Morante-robotics/spider-bot-replica/cad/chassis/design-review.md

# <Design> · design review

Each answer with the number or the picture that shows it, not «yes».

| Question | Answer and evidence |
|---|---|
| Fits: every face pair against `fits.py`, at the worst position | |
| Strength: smallest section of every feature that takes force | |
| Held: what stops each part in each direction (`RETAIN`) | |
| Assembly: the steps as Morante's hands do them; how it comes apart | |
| Seats: every part fully home (section at full depth) | |
| Print: orientation, overhang, where support goes, can pliers reach it, why each cavity exists | |
| Marks: which, where, visible in which step | |
| Carry-over: what earlier versions had and whether it is still here | |

## As a stranger would see it
Five things that could still be wrong or awkward, and what was done about each.

## Pre-mortem
The three most likely ways it fails when printed, cleaned and assembled, and what prevents each.
