Morante-robotics/spider-bot-replica/ai-log.md

# Spider-Bot · AI log

Where AI (Claude) helped with the build, what it was asked, and what was checked by hand. Rules: every AI suggestion
needs a measurable test; mechanism parts are modelled by AI in code (build123d) and assembled and animated by me in Onshape before printing; soldering, batteries and
assembly are done by me.

| Date | Phase | Task | AI did | Checked by |
|---|---|---|---|---|
| 2026-11-08 | 2 · CAD | Carcass base model | Searched for faithful models and compared licenses; measured the 9 STLs and checked them for mesh errors; wrote [`tools/stl_preview.py`](tools/stl_preview.py) and [`tools/stl_turntable.py`](tools/stl_turntable.py) for the previews; [`tools/assemble_jenscolt.py`](tools/assemble_jenscolt.py) to assemble the full robot (eye sockets measured from the mesh, leg layout approximate) | Opened in Bambu Studio: imports, same mesh errors reported. Leg count (8) from the author's photos; exact leg layout not checked |
| 2026-11-09 | 2 · CAD | Motor, battery holder and print scale | Collected motor and holder sizes from shop listings; worked out voltage for 2×AA / 4×AAA against the N20 and the LEDs; wrote [`tools/fit_check.py`](tools/fit_check.py) to find the free space in the body and the smallest scale for each part | Pending: holder drawing checked when bought; fit checked again in Onshape with the mechanism |
| 2026-11-09 | 2 · CAD | Mesh repair | Diagnosed the mesh errors; wrote [`tools/repair_stl.py`](tools/repair_stl.py); rejected MeshFix after measuring it removed a 1.5 mm relief | Bambu Studio `--info`: `manifold = yes` for the 5 repaired parts; max deviation from the original 0.01 mm |
| 2026-11-09 | 3 · Mechanisms | Leg simulator and comparison | Found Klann's patent bar lengths and Jansen's numbers; wrote [`sim/legs.py`](sim/legs.py) (circle-intersection solver, Grashof check, gait metrics); random search for the toy leg; caught and fixed two errors of its own (Jansen triangle sides swapped; toy stance measured off the ground). Mistake: ruled out the toy leg on a 2D model that cannot represent it and did not offer it as an option; Morante noticed and chose it | Klann and Jansen foot paths match the published shapes (DIY Walkers). Toy leg: pending a 3D model |
| 2026-11-09 | 3 · Mechanisms | Toy leg in 3D | Measured the 8 leg notches in the base mesh; wrote [`sim/toy_leg_3d.py`](sim/toy_leg_3d.py) (8 legs, two gait groups, quasi-static walk, stability, gaps, slip) and searched the geometry for 3 crank axle directions × 2 joint types, each at its best; added a «feet outside the body» check after the first run folded legs under the carcass | Pending: notch swing and fit with holder and motor checked in Onshape; foot path checked on a printed leg |
| 2026-11-09 | 3 · Mechanisms | Toy leg on one crankshaft | Added a shared-crankshaft mode and stricter clearance checks (all leg pairs, inner arms, crank discs inside the base and below the battery holder) to [`sim/toy_leg_3d.py`](sim/toy_leg_3d.py); found that the inner arms colliding, not the shaft, halve the stride. Mistake: the footprint minimum it chose twisted the legs | Pending: the same checks in CAD (step 3) and on a printed leg |
| 2026-11-09 | 3 · Mechanisms | Crankshaft against real parts, two side crankshafts, four lateral crankshafts | Added an arm-to-crankshaft clearance rule and the `sides` and `rows` modes to [`sim/toy_leg_3d.py`](sim/toy_leg_3d.py); found that one crankshaft cannot fit, that side shafts move the feet sideways, and that bob limits the four-shaft stride. Mistake: the one-crankshaft geometry chosen the day before had never been checked against solid cranks | Searches re-run with 3–5 seeds each; the four-shaft geometry checked again in CAD |
| 2026-11-10 | 3 · Mechanisms | Legs and drive in CAD | Added buildable limits to the search; wrote `cad/drive/build.py` (since split into [`cad/legs/`](cad/legs/), [`cad/crankshafts/`](cad/crankshafts/), [`cad/gear-train-test/`](cad/gear-train-test/) and [`cad/test-frame/`](cad/test-frame/)) (legs, forks, crankshafts with involute gears, idlers, spine, test frame) and [`cad/legs/check.py`](cad/legs/check.py) (overlap and gap of every pair over a full turn); fixed the six problems it found, one of them its own placement bug | `check.py`: no overlaps every 30°; Bambu Studio `--info`: `manifold = yes` for all STLs. Pending: Onshape assembly by Morante, a printed leg turned by hand |
| 2026-11-10 | 2 · CAD | Onshape assembly | Wrote the step-by-step tutorial [`cad/test-frame/onshape.md`](cad/test-frame/onshape.md) (first in Spanish, then in English), with the offsets worked out from the CAD parameters and the simulator's foot positions; wrote [`cad/test-frame/onshape_figures.py`](cad/test-frame/onshape_figures.py) for a picture of every mate. Mistake: did not say that the offset sign depends on the connector's axis | Morante assembled and animated it in Onshape; Claude checked the mates in the shared document. Foot positions not measured |
| 2026-11-10 | 2 · CAD | Clearance test and test leg print plate | Wrote [`cad/clearance-test/build.py`](cad/clearance-test/build.py) and [`tools/bambu_plate.py`](tools/bambu_plate.py) (orient, arrange and slice with Bambu Studio's CLI); found that the leg would not lie flat and fixed it; located the overhangs Bambu Studio cannot support. Mistake: the first fix (a wider leg) took away the clearance between the middle legs, caught by `check.py` | `check.py` over a full turn; Bambu Studio slice and preview. Pending: the printed parts and the clearance result |
| 2026-11-11 | 3 · Mechanisms | Test leg: first assembly and clearance result | Drew the screw diagram ([`cad/test-frame/screws_figure.py`](cad/test-frame/screws_figure.py)); found its own design faults from Morante's photos (frame arms ending at the centre of their holes; self-tapping holes M3 would not enter) and redesigned the fork's pivot; split the clearance in two from the block's result. Mistakes: the half-open arm holes and the 0.2 mm clearance guess | Morante's assembly and clearance block; `check.py` over a full turn. Reprint ([Test leg v2](build-log/3-legs-and-drive.md#test-leg-v2-turning-by-hand)): the frame holds and the leg turns with 0.5 mm; one fork came out too tight for the leg (0.2 mm a side in the window) |
| 2026-11-11 | 3 · Mechanisms | Base v1 in CAD | Widened the fork's window and thinned crankshaft 4's crank arms; checked the drive against the carcass body and found the forks and rear legs inside it; drew three ways out; wrote [`cad/base/build.py`](cad/base/build.py) (mesh booleans: band, hollow bowl, built-in spine with keel, fork pockets and screws, cap), [`cad/base/check.py`](cad/base/check.py) and [`cad/base/figures.py`](cad/base/figures.py). Mistakes: the drive had been designed against the base alone, never against the body; the first window fix gave 0.25 mm a side instead of 0.5, caught before printing | `check.py` every 10°: no overlaps against base, cap, front block and lifted body; Bambu Studio sliced the plate. Pending: print and assemble |
| 2026-11-11 | 3 · Mechanisms | Gear train test | Diagnosed the jam from Morante's video; wrote the general check [`tools/cad_verify.py`](tools/cad_verify.py) (integrity, collisions with gears turning, backlash, what holds each part, assembly order, overhangs), its [spec for this test](cad/gear-train-test/verify.py) and [`cad/crankshafts/gear_phase_figure.py`](cad/crankshafts/gear_phase_figure.py); found that idlers 1 and 2 cannot mesh with both crankshafts at the designed crank angles. Mistakes: the earlier check skipped gear pairs and never turned the idlers; the test spine had open slots and no cap; zero backlash | The new check reproduces both faults seen in the video (crankshafts lifting, jamming); it passes a closed bore and fails an open slot in a self-test. Redesign: [Gear train v2 in CAD](build-log/3-legs-and-drive.md#gear-train-v2-in-cad), pending its print |
| 2026-11-11 | 3 · Mechanisms | Gear train v2 in CAD | As the cad-designer subagent: worked out a gear offset per crankshaft so every idler meshes with both neighbours at the gait angles, raised idlers 1 and 2 to 12 teeth, added backlash, a test cap and assembly dots; wrote [`cad/crankshafts/check_gear_train.py`](cad/crankshafts/check_gear_train.py) and the new [spec](cad/gear-train-test/verify.py); rebuilt base v1's keel | `cad_verify` PASS every 5°, 2D mesh check every 1°, base and drive checks with no overlaps. Printed ([Gear train test v2: the cap](build-log/3-legs-and-drive.md#gear-train-test-v2-the-cap)): the train turns without the cap; the test cap jammed it |
| 2026-11-12 | 3 · Mechanisms | Gear train test v2: the cap | Diagnosed the jam from Morante's videos and caliper measurements; as the cad-designer subagent, narrowed the cap's tongues, added skirts to centre it, gave [`tools/cad_verify.py`](tools/cad_verify.py) keep-out zones and posed the cap and shafts at their extremes; applied the same fix to base v1's cap; drew [`cad/gear-train-test/assembly_figure.py`](cad/gear-train-test/assembly_figure.py). Mistakes: first blamed the backlash; the verifier had placed loose parts only at nominal and counted the crankshafts as holding the cap | `cad_verify` PASS every 5°, worst gap to a gear face 0.90 mm; the first cap fails the new spec. Morante printed the new cap: the four shafts turn together |
| 2026-11-14 | 3 · Mechanisms | Whole robot first: motor sizing and chassis plan | As a subagent, wrote [`sim/motor_sizing.py`](sim/motor_sizing.py) (crank torque over a turn by virtual work on the 3D toy leg, worst weight split by linear programming, joint friction, Pololu N20 data scaled to the battery voltage) and chose the HP 380:1. As the cad-designer subagent, wrote the whole-robot plan [`cad/chassis/design-plan.md`](cad/chassis/design-plan.md) in four revisions, with [`plan_figure.py`](cad/chassis/plan_figure.py) and [`mass_estimate.py`](cad/chassis/mass_estimate.py); the design-reviewer subagent checked it twice and asked for changes each time (among them leg 3R passing the motor at deck level, and a contingency by source on the mass). As the documenter, drew [`sim/motor_sizing_figure.py`](sim/motor_sizing_figure.py) and wrote the entry | Pending: the mass and sizing rerun on the modelled parts; the break coupons K6a and K6b (stall rule); the motor's margin and the train's efficiency (T1) on v0 |
