Morante-robotics/spider-bot-replica/cad/chassis/images/plan-top.png

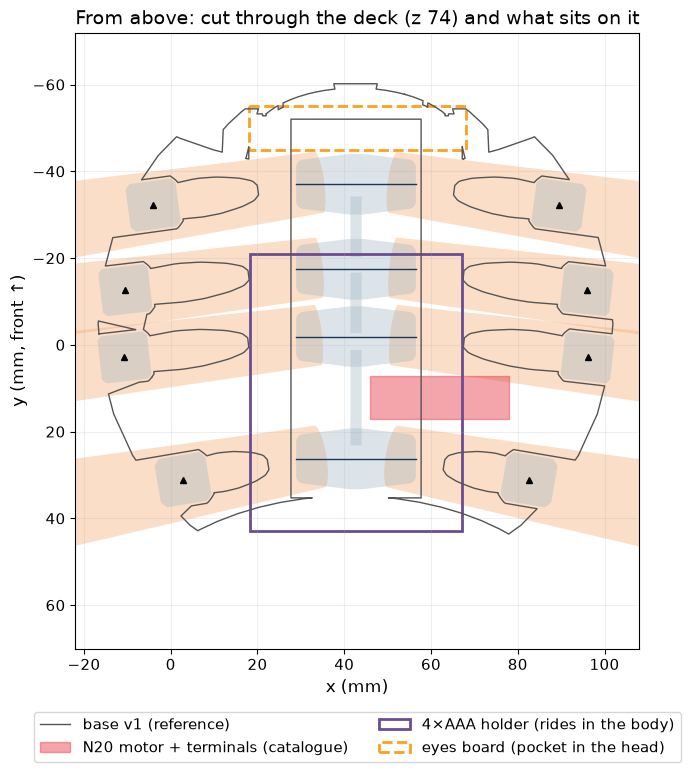
cad/chassis/images/plan-top.png
