Morante-robotics/spider-bot-replica/sim/images/drive-options.png

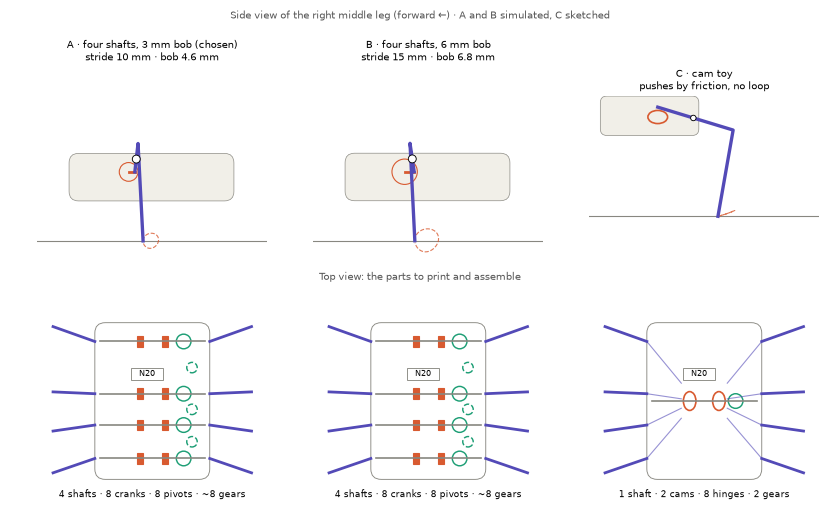
sim/images/drive-options.png
