Morante-robotics/spider-bot-replica/sim/images/toy-3d-rows-cad.gif

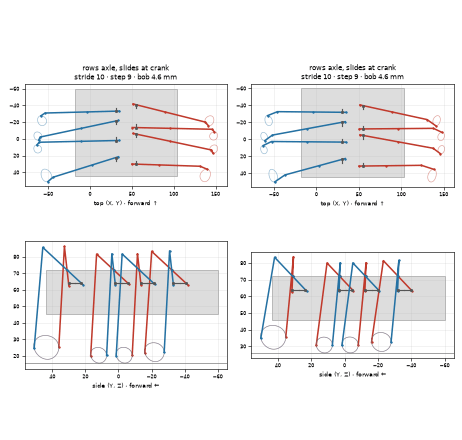
sim/images/toy-3d-rows-cad.gif
