Morante-robotics/spider-bot-replica/cad/legs/out/assembly-0.stl

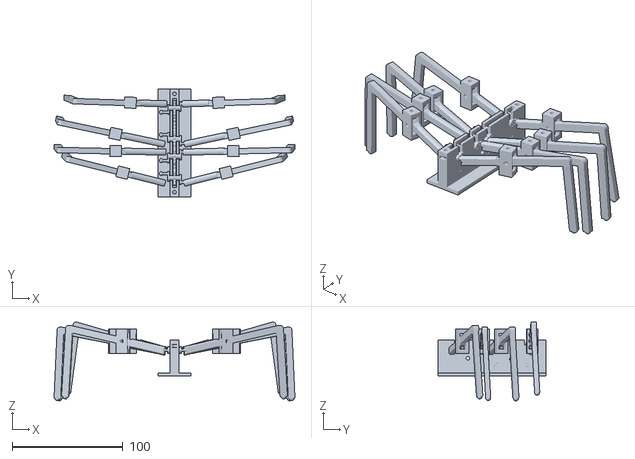
[picture p34: CAD file, 2026-11-11]
cad/legs/out/assembly-0.stl
218.0 x 97.3 x 71.3
