Morante-robotics/spider-bot-replica/cad/base/out/cap.stl

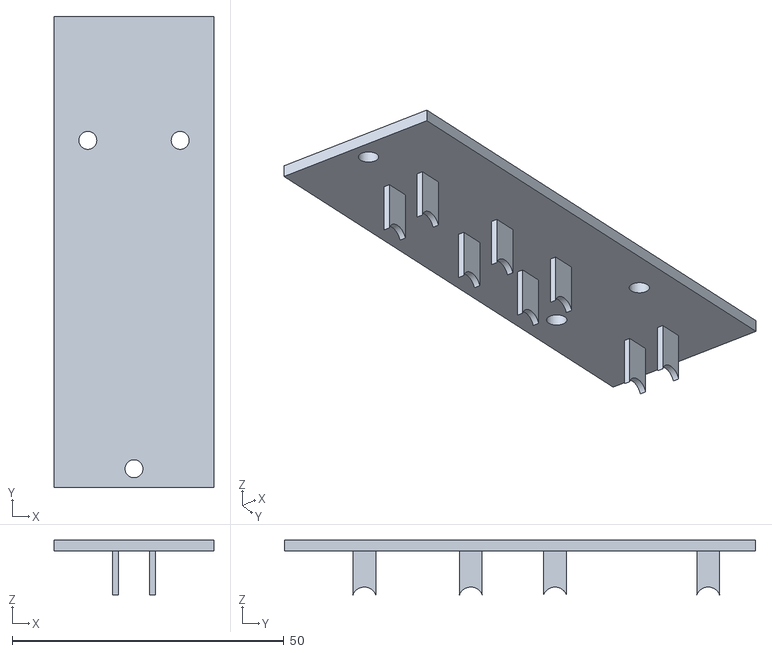
[picture p35: CAD file, 2026-11-12]
cad/base/out/cap.stl
29.4 x 86.7 x 10.1
