Morante-robotics/spider-bot-replica/cad/carcass-120/spideybot_eye.stl

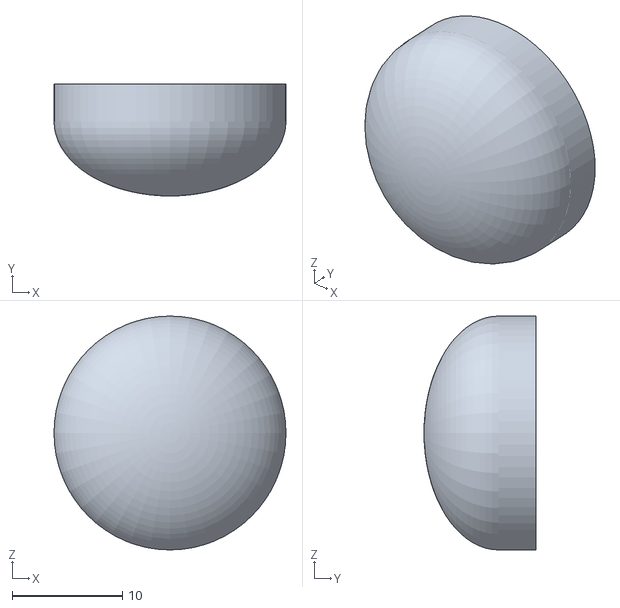
[picture p36: CAD file, 2026-11-09]
cad/carcass-120/spideybot_eye.stl
21.0 x 10.2 x 21.2
