Morante-robotics/spider-bot-replica/cad/carcass-jenscolt/spideybot_R_leg2.stl

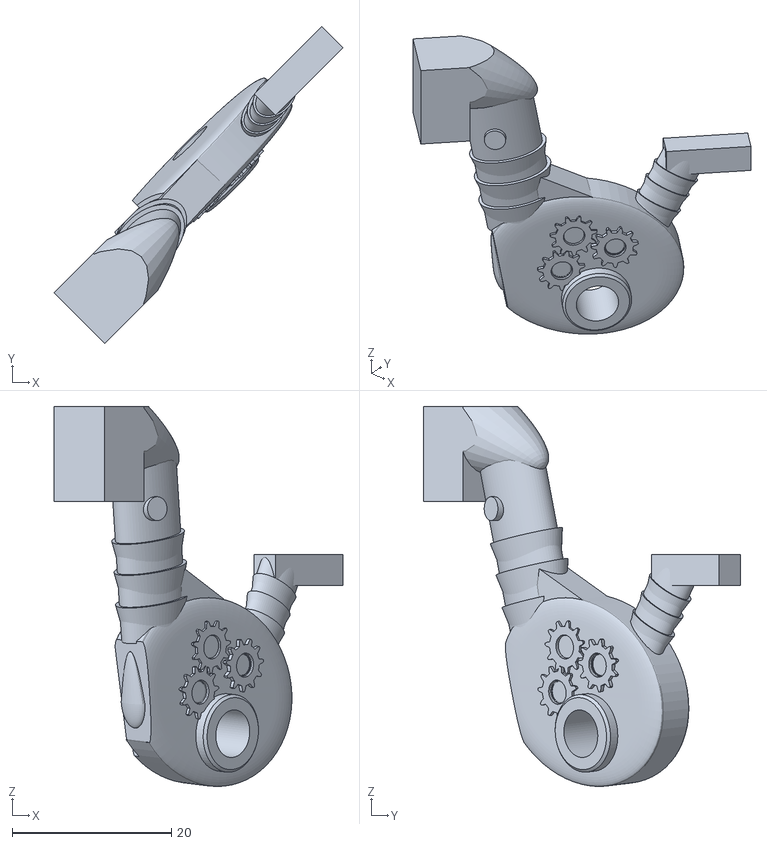
[picture p37: CAD file, 2026-11-07]
cad/carcass-jenscolt/spideybot_R_leg2.stl
36.3 x 39.9 x 47.8
