Morante-robotics/spider-bot-replica/cad/clearance-test/clearance-pin.step

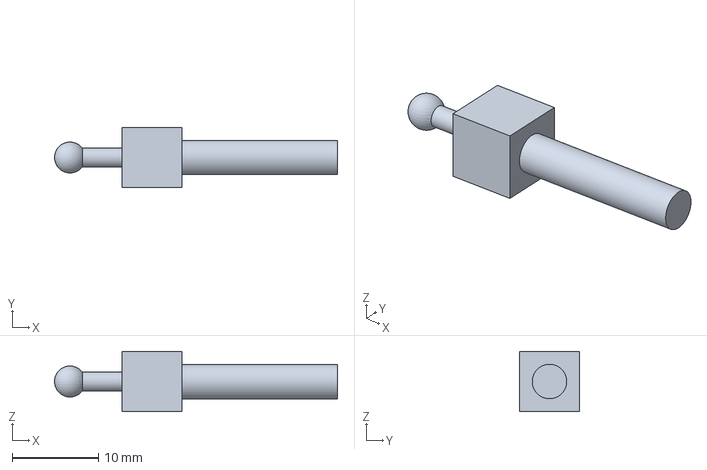
[picture p38: CAD file, 2026-11-10]
cad/clearance-test/clearance-pin.step
32.8 x 7.00 x 7.00 mm
