Morante-robotics/spider-bot-replica/cad/crankshafts/out/crankshaft-3.step

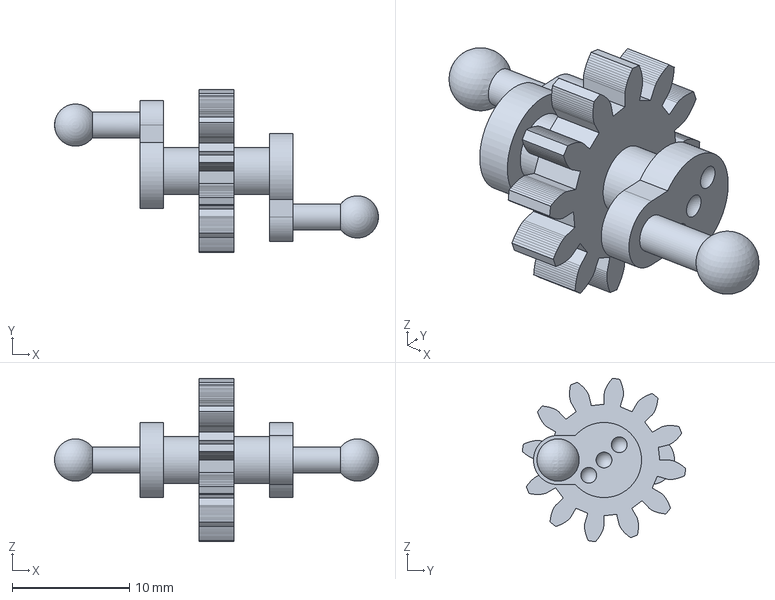
[picture p39: CAD file, 2026-11-11]
cad/crankshafts/out/crankshaft-3.step
27.6 x 13.9 x 13.9 mm
