Morante-robotics/spider-bot-replica/cad/gear-train-test/out/test-cap.step

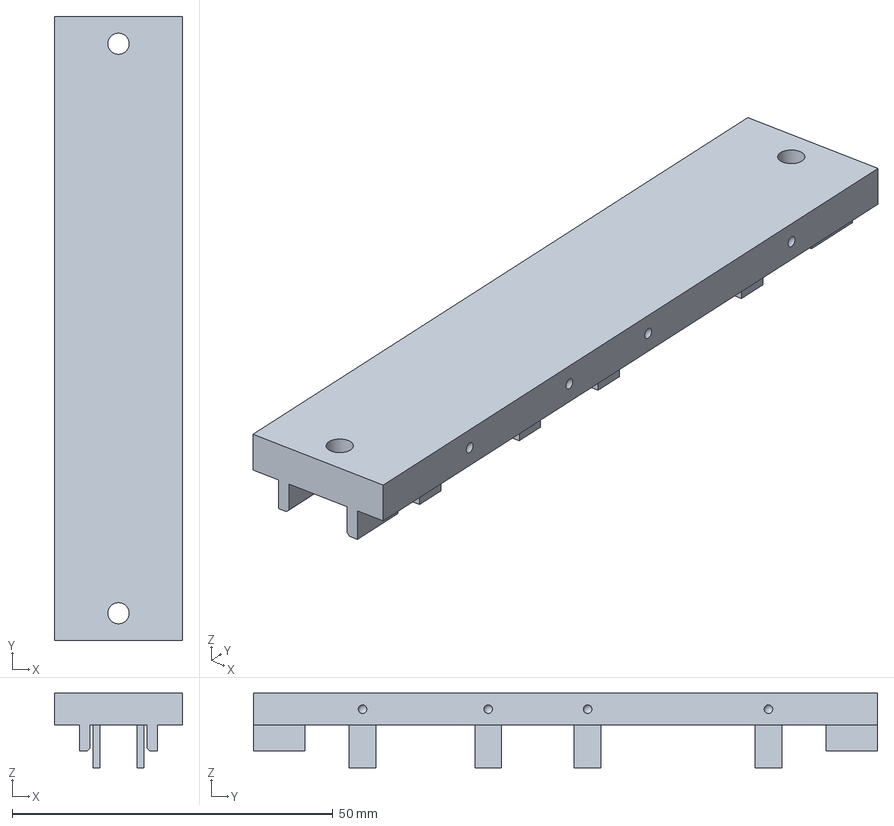
[picture p40: CAD file, 2026-11-12]
cad/gear-train-test/out/test-cap.step
20.0 x 97.3 x 11.6 mm
