Morante-robotics/spider-bot-replica/cad/test-frame/out/test-frame.step

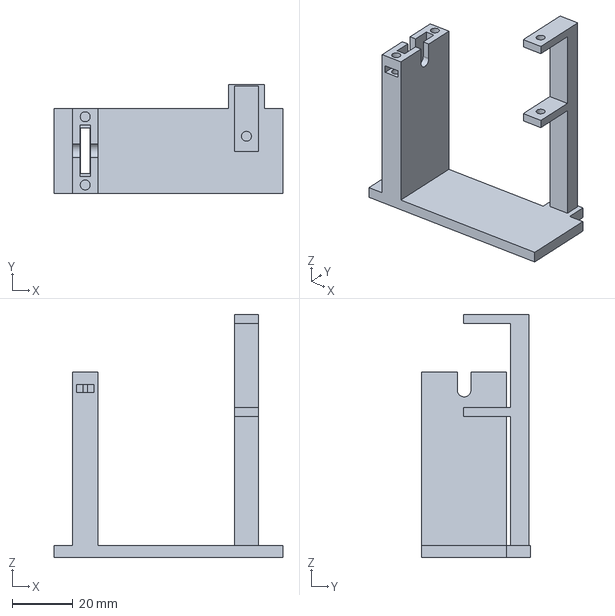
[picture p41: CAD file, 2026-11-11]
cad/test-frame/out/test-frame.step
75.4 x 35.8 x 80.1 mm
