Morante-robotics/spider-bot-replica/print/legs-forks-v1.3mf

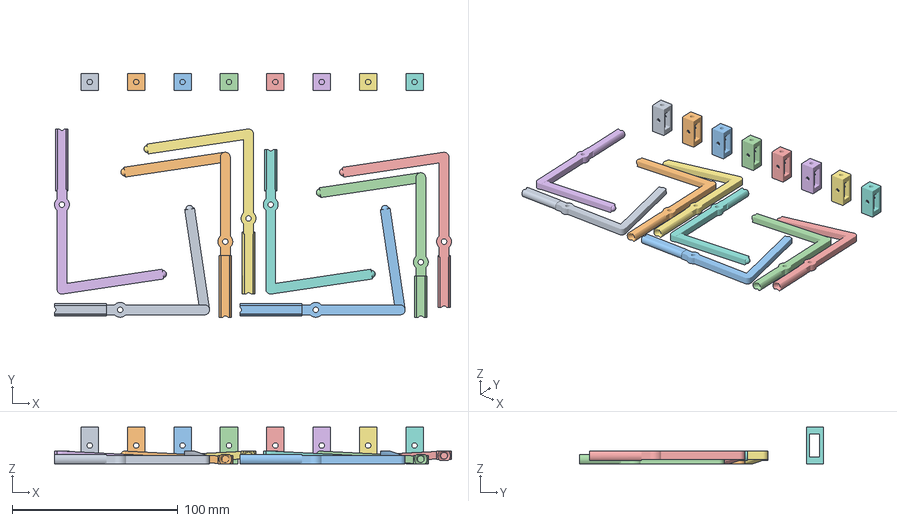
[picture p42: CAD file, 2026-11-12]
print/legs-forks-v1.3mf
239.6 x 147.0 x 22.0 mm
leg-front-right-0.stl
leg-middle-right-1.stl
leg-middle-right-2.stl
leg-rear-right-3.stl
leg-front-left-4.stl
leg-middle-left-5.stl
leg-middle-left-6.stl
leg-rear-left-7.stl
pivot-8.stl
pivot-9.stl
pivot-10.stl
pivot-11.stl
pivot-12.stl
pivot-13.stl
pivot-14.stl
pivot-15.stl
