Morante-robotics/spider-bot-replica/cad/base/out/base-v1.stl

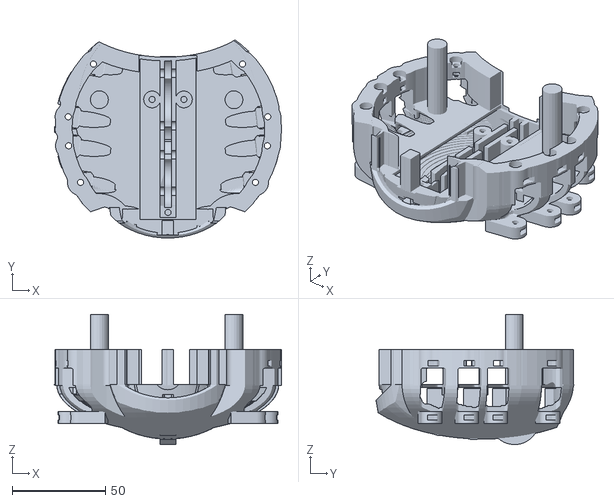
[picture p43: CAD file, 2026-11-11]
cad/base/out/base-v1.stl
121.4 x 106.0 x 69.6
