Morante-robotics/spider-bot-replica/cad/carcass-120/spideybot_sensor.stl

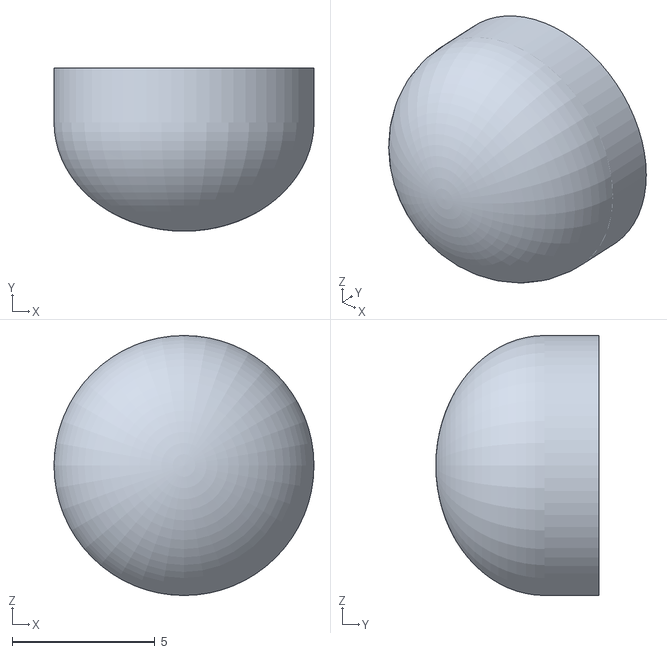
[picture p44: CAD file, 2026-11-09]
cad/carcass-120/spideybot_sensor.stl
9.12 x 5.73 x 9.12
