Morante-robotics/spider-bot-replica/cad/carcass-jenscolt/spideybot_small_eye.stl

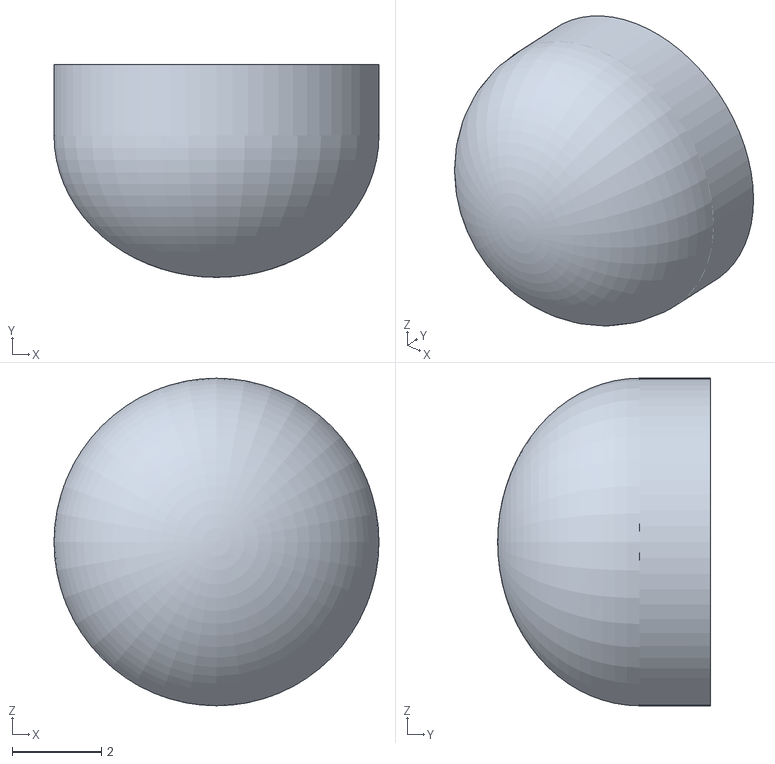
[picture p45: CAD file, 2026-11-07]
cad/carcass-jenscolt/spideybot_small_eye.stl
7.30 x 4.78 x 7.36
