Morante-robotics/spider-bot-replica/cad/clearance-test/clearance-block.step

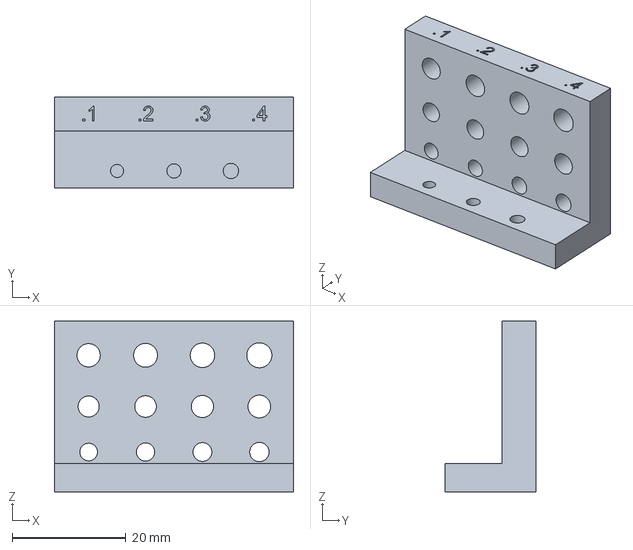
[picture p46: CAD file, 2026-11-10]
cad/clearance-test/clearance-block.step
42.0 x 16.0 x 30.0 mm
