Morante-robotics/spider-bot-replica/cad/gear-train-test/out/spine.step

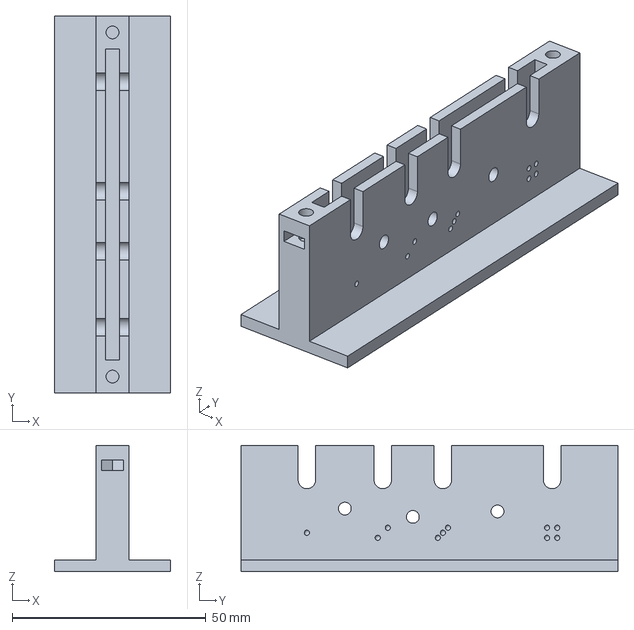
[picture p47: CAD file, 2026-11-11]
cad/gear-train-test/out/spine.step
30.0 x 97.3 x 32.5 mm
