Morante-robotics/spider-bot-replica/cad/legs/out/leg-front-right.step

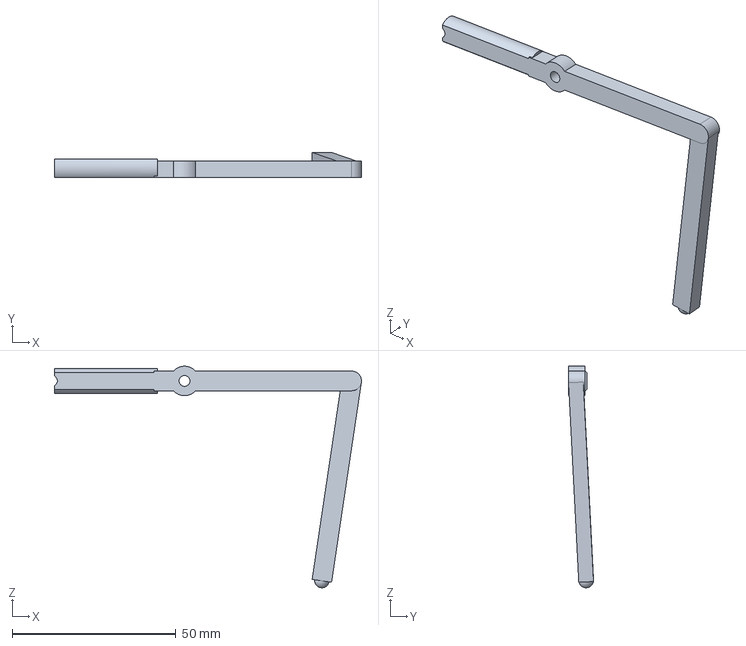
[picture p48: CAD file, 2026-11-11]
cad/legs/out/leg-front-right.step
93.6 x 7.62 x 67.6 mm
