Morante-robotics/spider-bot-replica/cad/test-frame/out/test-frame-keeper.step

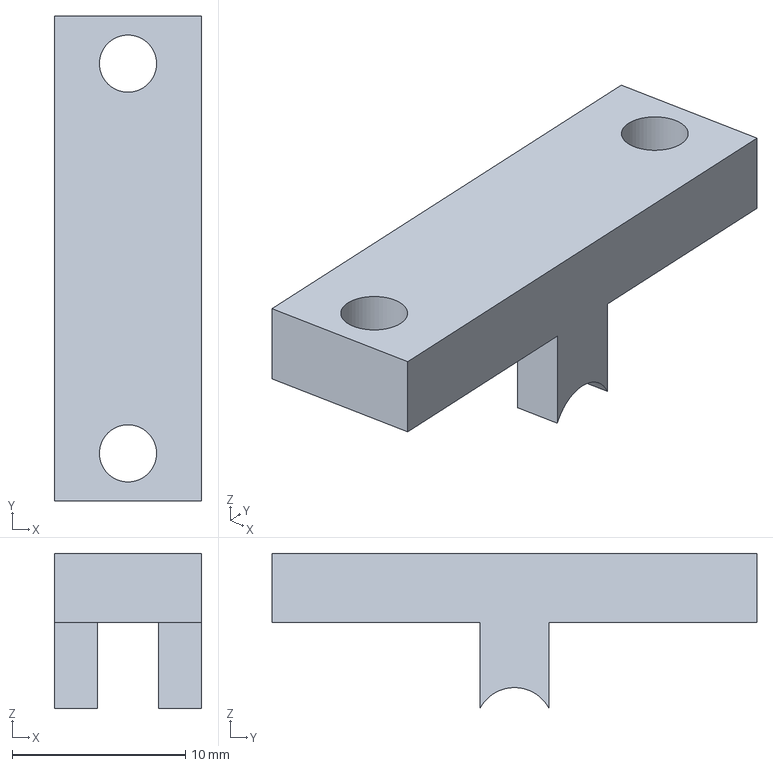
[picture p49: CAD file, 2026-11-11]
cad/test-frame/out/test-frame-keeper.step
8.50 x 28.0 x 8.97 mm
