Morante-robotics/spider-bot-replica/print/base-v1.3mf

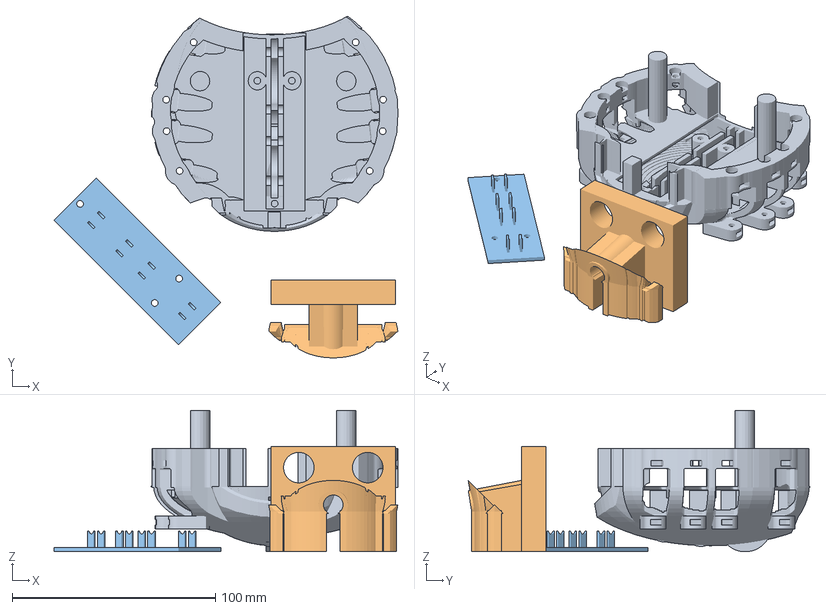
[picture p50: CAD file, 2026-11-12]
print/base-v1.3mf
169.3 x 168.2 x 69.6 mm
base-v1.stl
front-block.stl
cap.stl
