Morante-robotics/spider-bot-replica/cad/base/out/front-block.stl

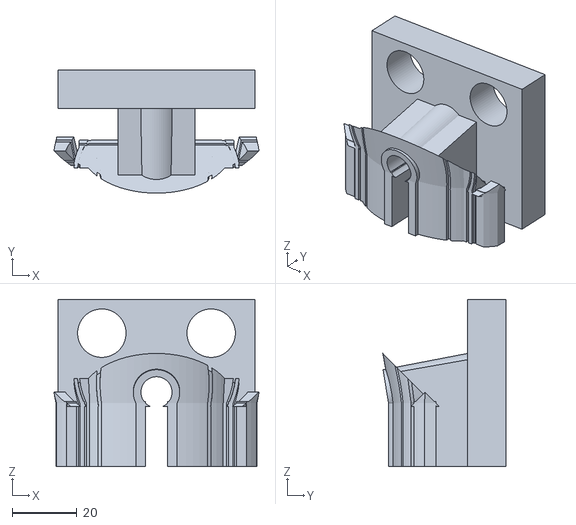
[picture p51: CAD file, 2026-11-11]
cad/base/out/front-block.stl
63.5 x 38.2 x 51.9
