Morante-robotics/spider-bot-replica/cad/carcass-120/spideybot_body.stl

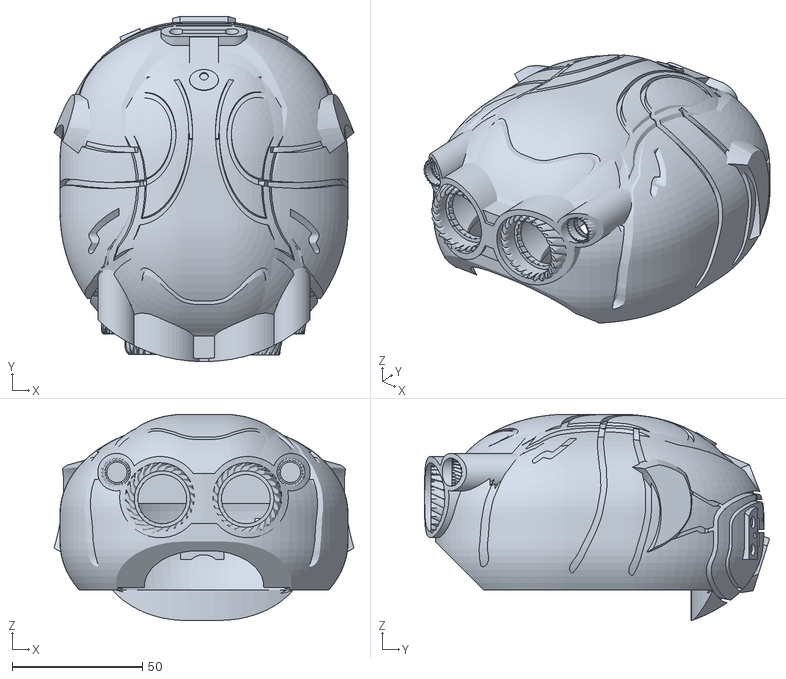
[picture p52: CAD file, 2026-11-09]
cad/carcass-120/spideybot_body.stl
115.2 x 132.6 x 79.2
