Morante-robotics/spider-bot-replica/cad/carcass-jenscolt/spideybot_L_leg1.stl

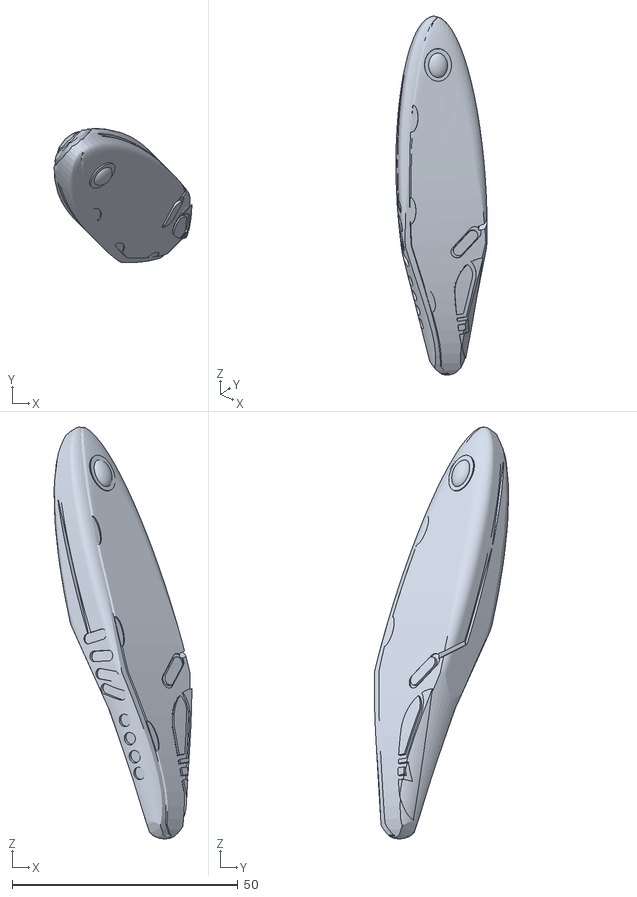
[picture p53: CAD file, 2026-11-07]
cad/carcass-jenscolt/spideybot_L_leg1.stl
30.5 x 29.7 x 91.3
