Morante-robotics/spider-bot-replica/cad/crankshafts/out/idler-2.step

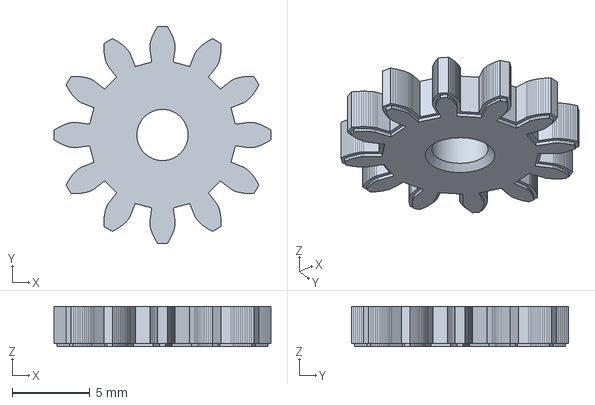
[picture p54: CAD file, 2026-11-11]
cad/crankshafts/out/idler-2.step
14.0 x 14.0 x 2.60 mm
