Morante-robotics/spider-bot-replica/cad/legs/out/leg-rear-left.step

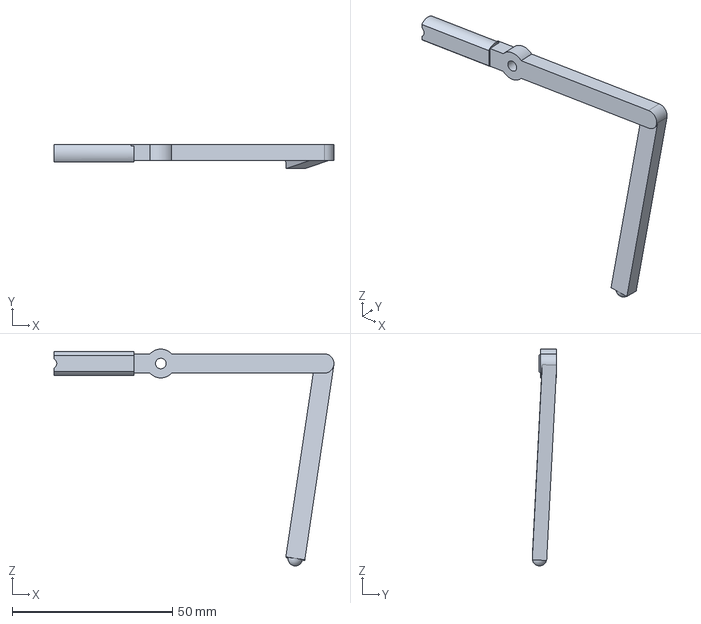
[picture p55: CAD file, 2026-11-11]
cad/legs/out/leg-rear-left.step
87.3 x 7.62 x 67.6 mm
