Morante-robotics/spider-bot-replica/cad/carcass-120/spideybot_base.stl

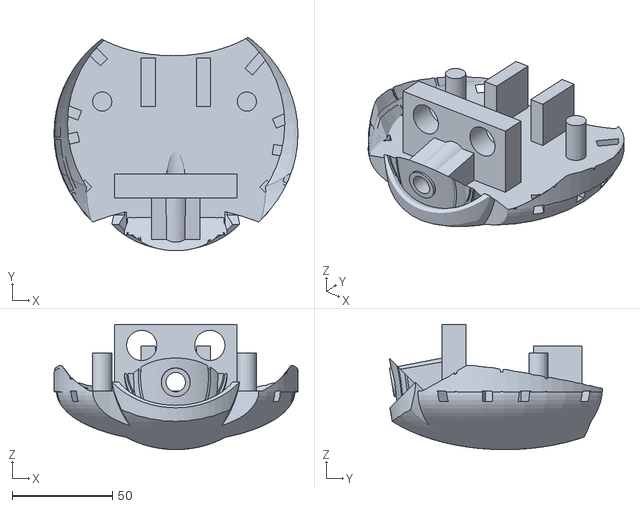
[picture p56: CAD file, 2026-11-09]
cad/carcass-120/spideybot_base.stl
121.4 x 106.2 x 62.4
