Morante-robotics/spider-bot-replica/cad/carcass-jenscolt/spideybot_eye.stl

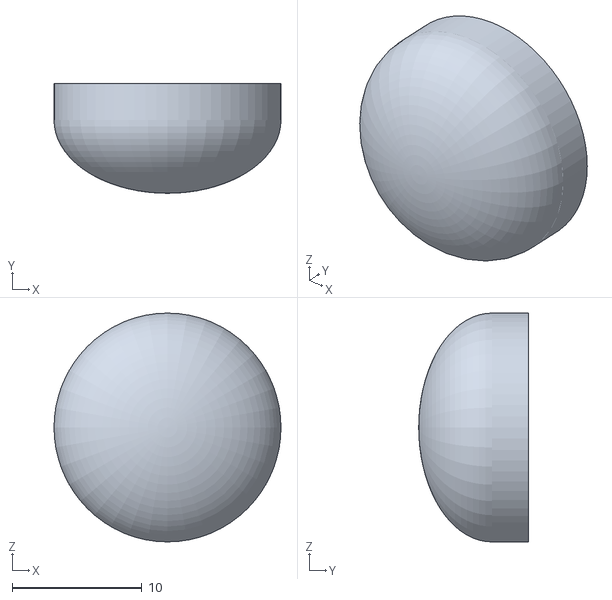
[picture p57: CAD file, 2026-11-07]
cad/carcass-jenscolt/spideybot_eye.stl
17.5 x 8.46 x 17.7
