Morante-robotics/spider-bot-replica/cad/crankshafts/out/crankshaft-4.step

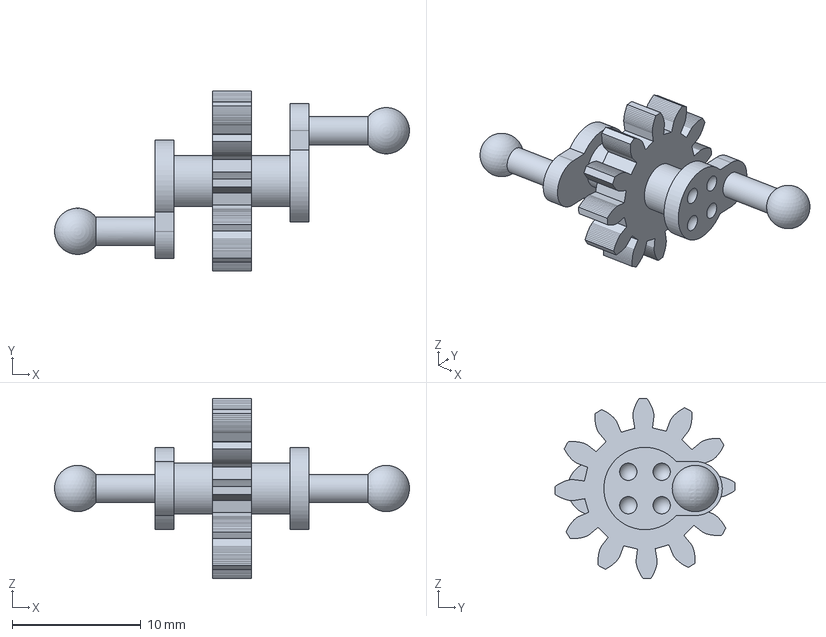
[picture p58: CAD file, 2026-11-11]
cad/crankshafts/out/crankshaft-4.step
27.6 x 14.0 x 14.0 mm
