Morante-robotics/spider-bot-replica/cad/legs/out/leg-middle-right.step

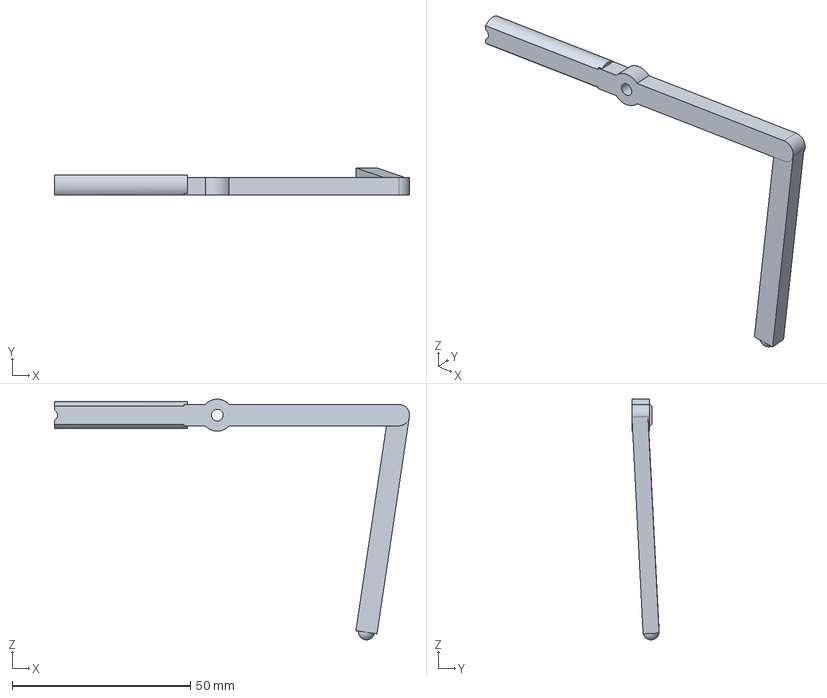
[picture p59: CAD file, 2026-11-11]
cad/legs/out/leg-middle-right.step
99.7 x 7.62 x 67.6 mm
