Morante-robotics/spider-bot-replica/print/gear-train-test-v2.3mf

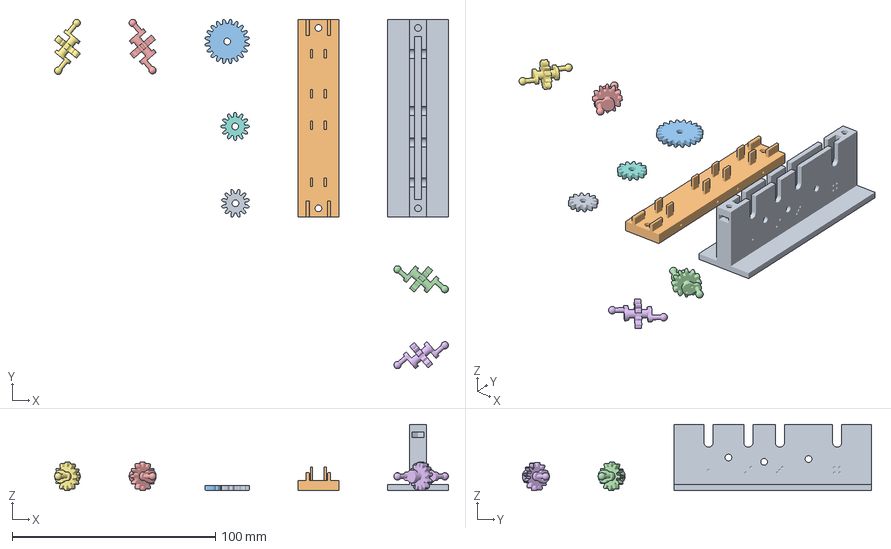
[picture p60: CAD file, 2026-11-12]
print/gear-train-test-v2.3mf
193.9 x 172.0 x 32.5 mm
spine.stl
test-cap.stl
idler-3.stl
crankshaft-2.stl
crankshaft-1.stl
crankshaft-3.stl
crankshaft-4.stl
idler-1.stl
idler-2.stl
