Morante-robotics/spider-bot-replica/cad/carcass-120/spideybot_small_eye.stl

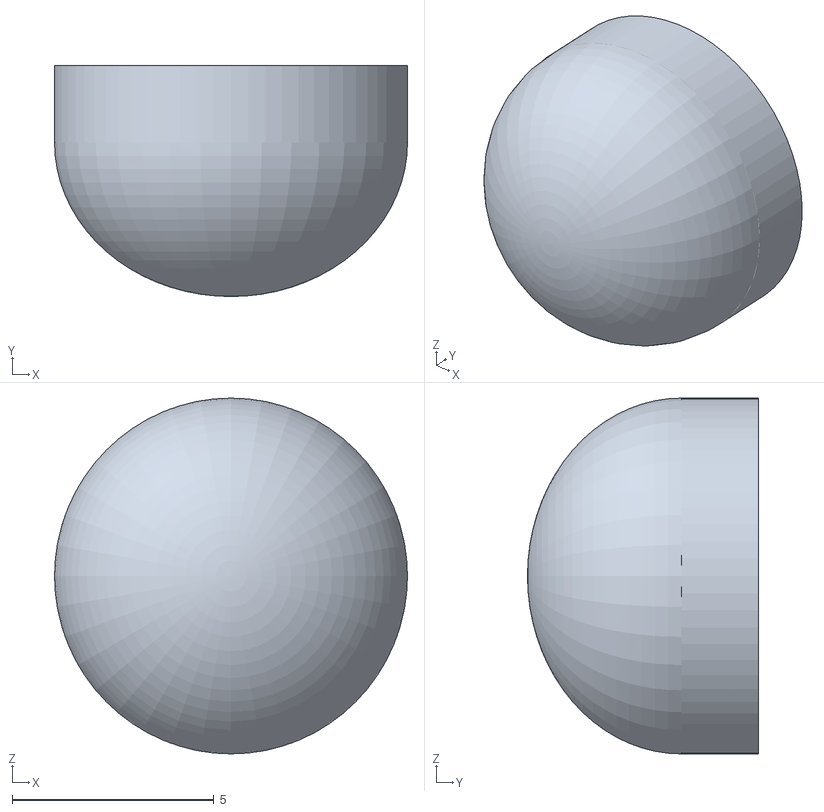
[picture p61: CAD file, 2026-11-09]
cad/carcass-120/spideybot_small_eye.stl
8.76 x 5.73 x 8.83
