Morante-robotics/spider-bot-replica/cad/carcass-jenscolt/spideybot_body.stl

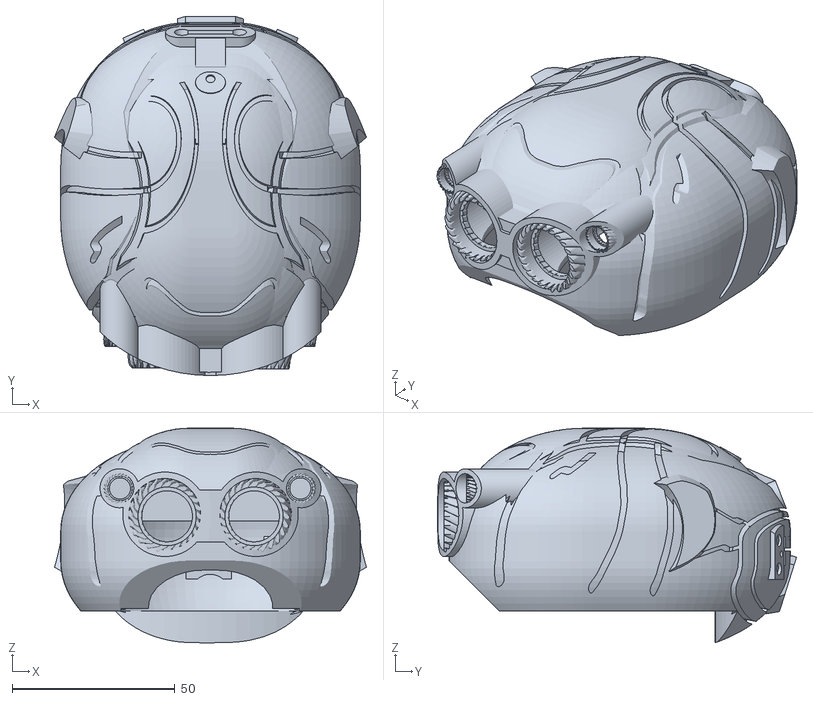
[picture p62: CAD file, 2026-11-07]
cad/carcass-jenscolt/spideybot_body.stl
96.0 x 110.5 x 66.1
