Morante-robotics/spider-bot-replica/cad/crankshafts/out/idler-3.step

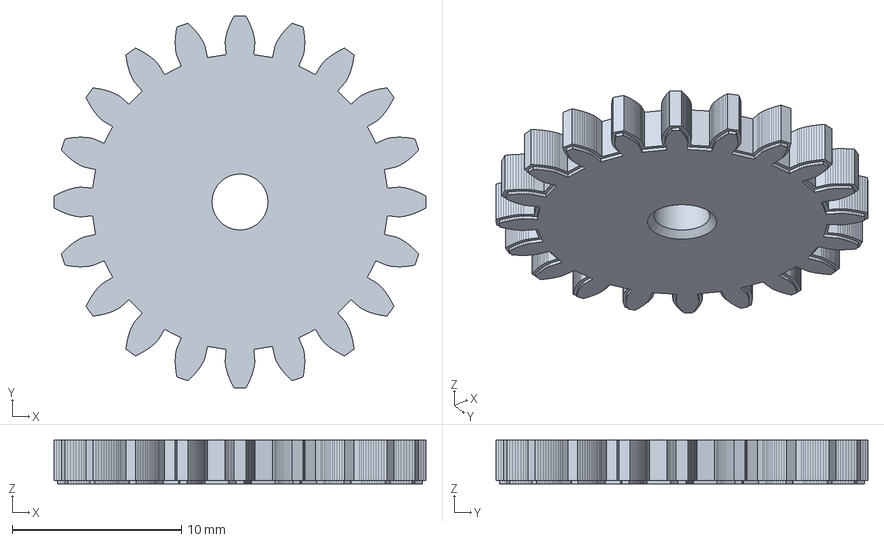
[picture p63: CAD file, 2026-11-11]
cad/crankshafts/out/idler-3.step
22.0 x 22.0 x 2.60 mm
