Morante-robotics/spider-bot-replica/cad/legs/out/pivot.step

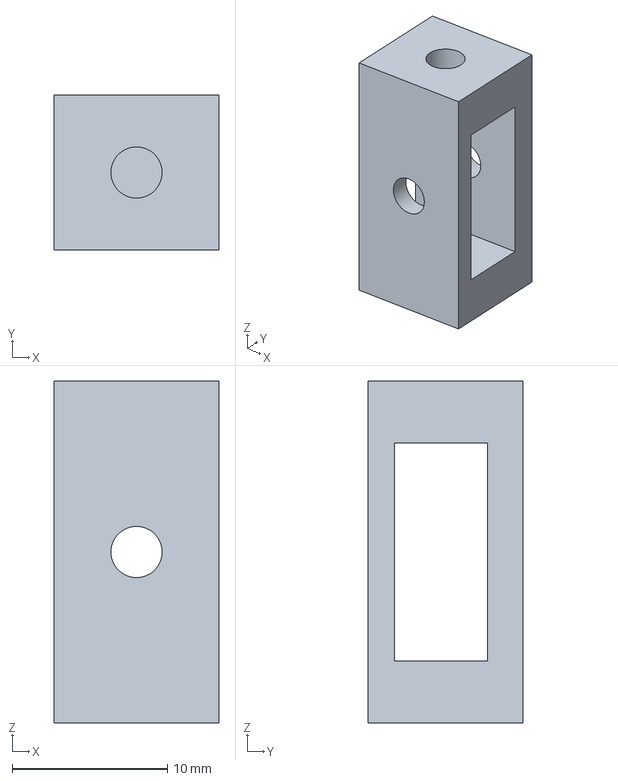
[picture p64: CAD file, 2026-11-11]
cad/legs/out/pivot.step
10.6 x 10.0 x 22.0 mm
