Morante-robotics/spider-bot-replica/print/test-frame-v2.3mf

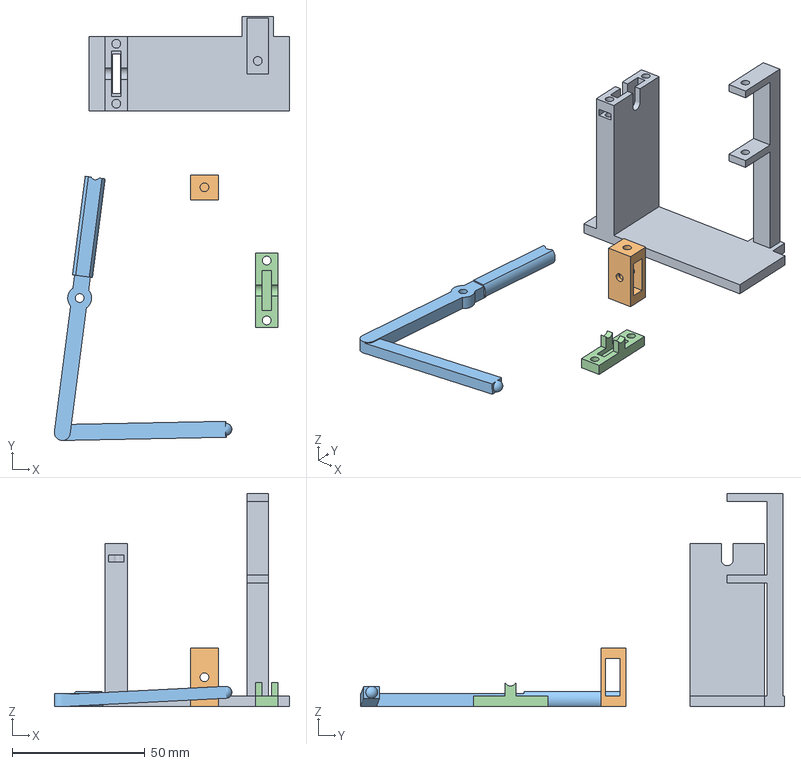
[picture p65: CAD file, 2026-11-11]
print/test-frame-v2.3mf
88.5 x 159.4 x 80.1 mm
test-frame.stl
pivot.stl
leg-middle-right.stl
test-frame-keeper.stl
