Morante-robotics/spider-bot-replica/cad/carcass-jenscolt/spideybot_sensor.stl

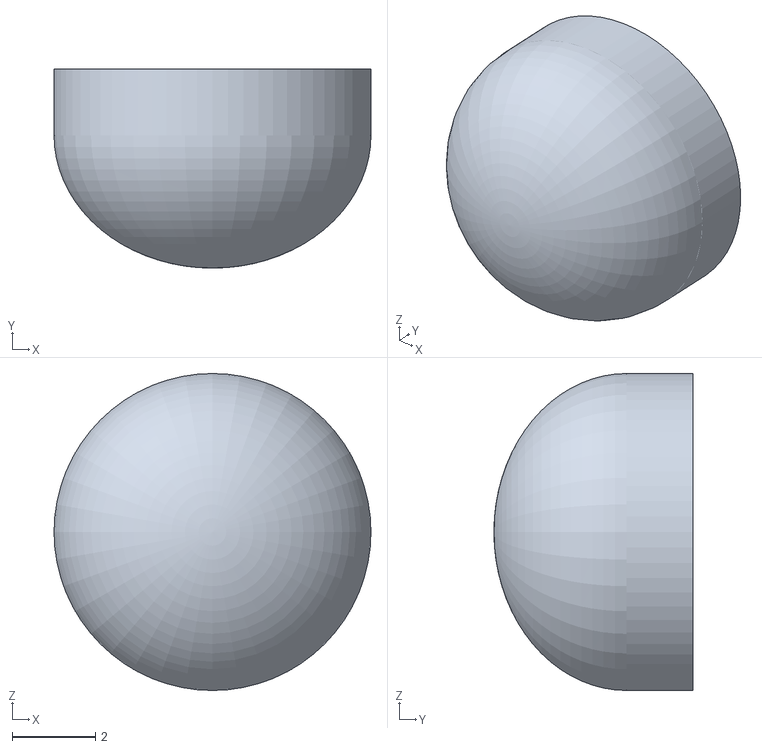
[picture p66: CAD file, 2026-11-07]
cad/carcass-jenscolt/spideybot_sensor.stl
7.60 x 4.78 x 7.60
