Morante-robotics/spider-bot-replica/print/test-leg-plate.3mf

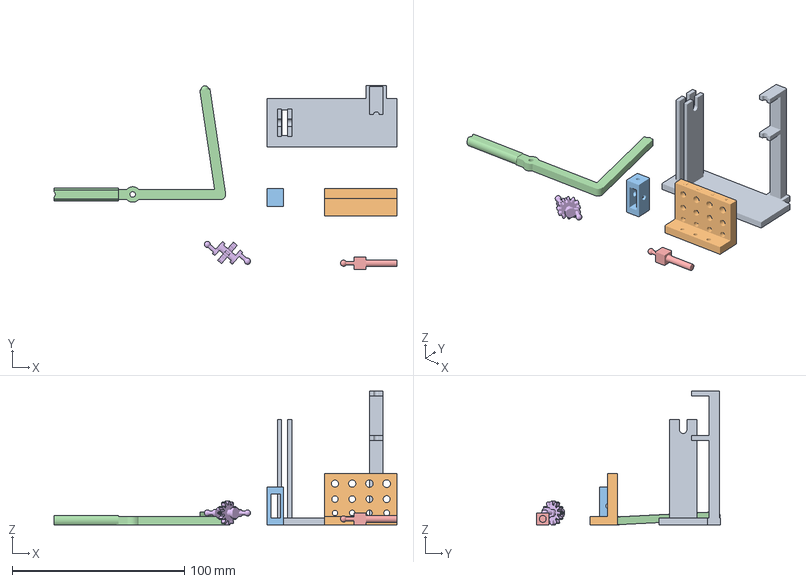
[picture p67: CAD file, 2026-11-10]
print/test-leg-plate.3mf
199.1 x 106.5 x 77.7 mm
test-frame.stl
clearance-block.stl
pivot.stl
leg-middle-right.stl
clearance-pin.stl
crankshaft-2.stl
