Morante-robotics/spider-bot-replica/cad/carcass-jenscolt/spideybot_base.stl

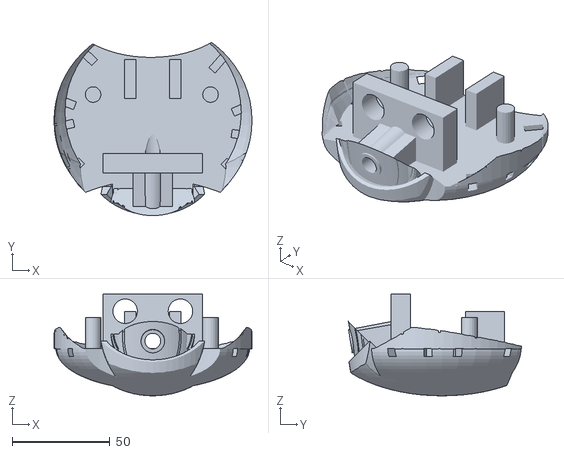
[picture p68: CAD file, 2026-11-07]
cad/carcass-jenscolt/spideybot_base.stl
101.2 x 88.5 x 52.0
