Morante-robotics/spider-bot-replica/(list of files, cad)

Other CAD files:
cad/crankshafts/out/crankshaft-2.step
print/test-cap-v2.3mf
cad/carcass-jenscolt/spideybot_R_leg1.stl
cad/crankshafts/out/idler-1.step
cad/legs/out/leg-middle-left.step
cad/crankshafts/out/crankshaft-1.step
cad/legs/out/leg-front-left.step
cad/legs/out/leg-rear-right.step
cad/carcass-jenscolt/spideybot_L_leg2.stl
cad/clearance-test/clearance-block.stl
cad/clearance-test/clearance-pin.stl
cad/crankshafts/out/crankshaft-1.stl
cad/crankshafts/out/crankshaft-2.stl
cad/crankshafts/out/crankshaft-3.stl
cad/crankshafts/out/crankshaft-4.stl
cad/crankshafts/out/idler-1.stl
cad/crankshafts/out/idler-2.stl
cad/crankshafts/out/idler-3.stl
cad/gear-train-test/out/spine.stl
cad/gear-train-test/out/test-cap.stl
cad/legs/out/leg-front-left.stl
cad/legs/out/leg-front-right.stl
cad/legs/out/leg-middle-left.stl
cad/legs/out/leg-middle-right.stl
cad/legs/out/leg-rear-left.stl
cad/legs/out/leg-rear-right.stl
cad/legs/out/pivot.stl
cad/test-frame/out/test-frame-keeper.stl
cad/test-frame/out/test-frame.stl
print/gear-train-test.3mf
