Morante-robotics/spider-bot-replica/cad/gear-train-test/images/verify/assembly.png

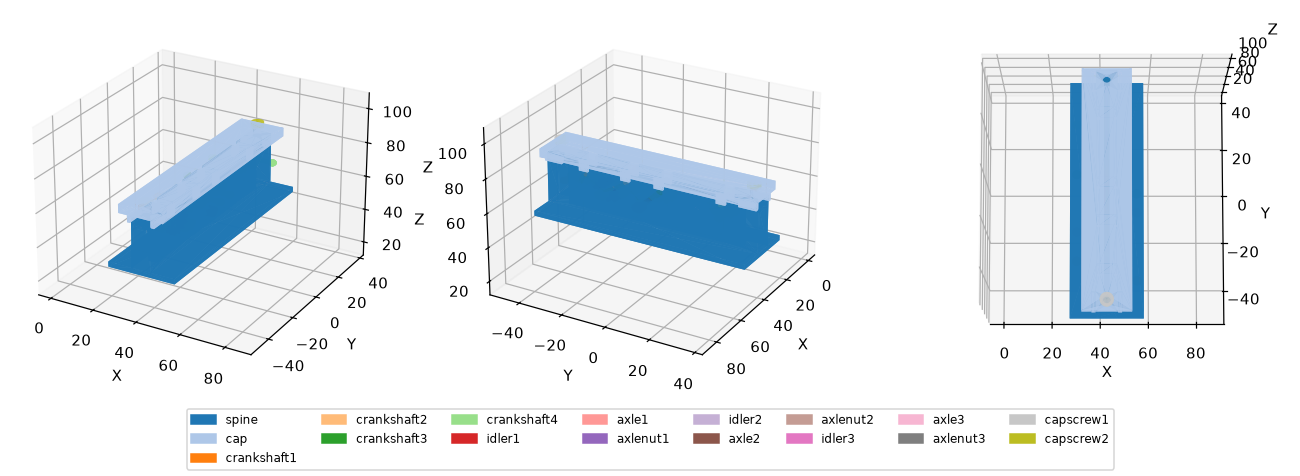
cad/gear-train-test/images/verify/assembly.png
