Morante-robotics/spider-bot-replica/cad/gear-train-test/verify-result.txt

cad_verify: PASS (0 failures, 0 warnings)

== 1 integrity (printed parts)
  ok    spine: closed solid, 23493 mm³, 30.0 × 97.3 × 32.5 mm; walls ≥ 0.8 mm
  ok    cap: closed solid, 10091 mm³, 20.0 × 97.3 × 11.7 mm; walls ≥ 0.8 mm
  ok    crankshaft1: closed solid, 649 mm³, 27.6 × 14.0 × 14.0 mm; walls ≥ 0.8 mm
  ok    crankshaft2: closed solid, 648 mm³, 27.6 × 14.0 × 14.0 mm; walls ≥ 0.8 mm
  ok    crankshaft3: closed solid, 648 mm³, 27.6 × 13.9 × 13.9 mm; walls ≥ 0.8 mm
  ok    crankshaft4: closed solid, 608 mm³, 27.6 × 14.0 × 14.0 mm; walls ≥ 0.8 mm
  ok    idler1: closed solid, 254 mm³, 14.0 × 14.0 × 2.6 mm; walls ≥ 0.8 mm
  ok    idler2: closed solid, 254 mm³, 14.0 × 14.0 × 2.6 mm; walls ≥ 0.8 mm
  ok    idler3: closed solid, 768 mm³, 22.0 × 22.0 × 2.6 mm; walls ≥ 0.8 mm

== 2 motion: overlaps and gaps at every step   3 gears: backlash
  ok    no undeclared overlaps over 96 steps
        axle3 × idler3: gap 0.15 mm (closest at (0, 0.0))
        axle2 × idler2: gap 0.15 mm (closest at (170, 0.0))
        axle1 × idler1: gap 0.15 mm (closest at (170, 0.0))
        capscrew1 × spine: gap 0.15 mm (closest at (0, 0.0))
        capscrew2 × spine: gap 0.15 mm (closest at (0, 0.0))
        crankshaft1 × spine: gap 0.25 mm (closest at (15, 0.0))
        crankshaft4 × spine: gap 0.25 mm (closest at (15, 0.0))
        crankshaft2 × spine: gap 0.25 mm (closest at (45, 0.0))
        crankshaft3 × spine: gap 0.25 mm (closest at (225, 0.0))
        cap × crankshaft1: gap 0.25 mm (closest at (0, 0.0))
        cap × crankshaft2: gap 0.25 mm (closest at (0, 0.0))
        cap × crankshaft3: gap 0.25 mm (closest at (0, 0.0))
        cap × crankshaft4: gap 0.25 mm (closest at (0, 0.0))
        idler1 × spine: gap 0.45 mm (closest at (0, 0.0))
        idler2 × spine: gap 0.45 mm (closest at (0, 0.0))
        idler3 × spine: gap 0.45 mm (closest at (0, 0.0))
        axle1 × spine: contact allowed (screw head tightened on the +X wall (shank in a Ø3.3 hole))
        axle2 × spine: contact allowed (screw head tightened on the +X wall (shank in a Ø3.3 hole))
        axle3 × spine: contact allowed (screw head tightened on the +X wall (shank in a Ø3.3 hole))
        axlenut1 × spine: contact allowed (nut tightened on the -X wall)
        axlenut2 × spine: contact allowed (nut tightened on the -X wall)
        axlenut3 × spine: contact allowed (nut tightened on the -X wall)
        axle1 × axlenut1: contact allowed (nut on its screw)
        axle2 × axlenut2: contact allowed (nut on its screw)
        axle3 × axlenut3: contact allowed (nut on its screw)
        cap × capscrew1: contact allowed (screw head clamps the cap (shank in a Ø3.3 hole))
        cap × capscrew2: contact allowed (screw head clamps the cap (shank in a Ø3.3 hole))
        cap × spine: contact allowed (cap sits on the spine's top, tongues slide in the slots (0.15 mm a side, CAP_CLR), skirts 0.2 mm off the walls' outer faces (they touch at the X extremes))
  ok    gears crankshaft3 × idler2: gap 0.10–0.10 mm over the motion
  ok    gears crankshaft2 × idler2: gap 0.10–0.10 mm over the motion
  ok    gears crankshaft2 × idler1: gap 0.10–0.10 mm over the motion
  ok    gears crankshaft1 × idler1: gap 0.10–0.10 mm over the motion
  ok    gears crankshaft3 × idler3: gap 0.10–0.10 mm over the motion
  ok    gears crankshaft4 × idler3: gap 0.10–0.10 mm over the motion

== 4 retention: can a part fall, lift or tip out?
  ok    cap: held within 0.5 mm / 5.0° (free:  slide)
  ok    crankshaft1: held within 0.5 mm / 5.0° (free: spin)
  ok    crankshaft2: held within 0.5 mm / 5.0° (free: spin)
  ok    crankshaft3: held within 0.5 mm / 5.0° (free: spin)
  ok    crankshaft4: held within 0.5 mm / 5.0° (free: spin)
  ok    idler1: held within 1.0 mm / 5.0° (free: spin)
  ok    idler2: held within 1.0 mm / 5.0° (free: spin)
  ok    idler3: held within 1.0 mm / 5.0° (free: spin)

== 5 assembly order
  ok    idler1 goes in from +Z
  ok    idler2 goes in from +Z
  ok    idler3 goes in from +Z
  ok    axle1 goes in from +X
  ok    axle2 goes in from +X
  ok    axle3 goes in from +X
  ok    axlenut1 goes in from -X
  ok    axlenut2 goes in from -X
  ok    axlenut3 goes in from -X
  ok    crankshaft1 goes in from +Z
  ok    crankshaft2 goes in from +Z
  ok    crankshaft3 goes in from +Z
  ok    crankshaft4 goes in from +Z
  ok    cap goes in from +Z
  ok    capscrew1 goes in from +Z
  ok    capscrew2 goes in from +Z

== 6 print (overhangs over 45°, in print orientation)
        spine: 103 mm² of overhang needing support
        cap: no overhangs
        crankshaft1: 131 mm² of overhang needing support
        crankshaft2: 134 mm² of overhang needing support
        crankshaft3: 135 mm² of overhang needing support
        crankshaft4: 128 mm² of overhang needing support
        idler1: no overhangs
        idler2: no overhangs
        idler3: no overhangs

== 7 keep-out zones (moving with their part, at every step)
  ok    gear1-axial (gear faces + 0.25 float + 0.8 mm axial): clear over 96 steps; closest cap, 0.10 mm outside it (at (0, -0.2))
        gear1-axial: not checked against spine, idler1, idler2, idler3 (idlers mesh in the gear plane (GEARS checks them); the spine walls are 0.25 mm off the gear faces (0-0.5 with the float) as in v2, which turned freely without the cap, 2026-11-12)
  ok    gear2-axial (gear faces + 0.25 float + 0.8 mm axial): clear over 96 steps; closest cap, 0.10 mm outside it (at (0, -0.2))
        gear2-axial: not checked against spine, idler1, idler2, idler3 (idlers mesh in the gear plane (GEARS checks them); the spine walls are 0.25 mm off the gear faces (0-0.5 with the float) as in v2, which turned freely without the cap, 2026-11-12)
  ok    gear3-axial (gear faces + 0.25 float + 0.8 mm axial): clear over 96 steps; closest cap, 0.10 mm outside it (at (0, -0.2))
        gear3-axial: not checked against spine, idler1, idler2, idler3 (idlers mesh in the gear plane (GEARS checks them); the spine walls are 0.25 mm off the gear faces (0-0.5 with the float) as in v2, which turned freely without the cap, 2026-11-12)
  ok    gear4-axial (gear faces + 0.25 float + 0.8 mm axial): clear over 96 steps; closest cap, 0.10 mm outside it (at (0, -0.2))
        gear4-axial: not checked against spine, idler1, idler2, idler3 (idlers mesh in the gear plane (GEARS checks them); the spine walls are 0.25 mm off the gear faces (0-0.5 with the float) as in v2, which turned freely without the cap, 2026-11-12)
