Morante-robotics/spider-bot-replica/cad/base/check-result.txt

0° 10° 20° 30° 40° 50° 60° 70° 80° 90° 100° 110° 120° 130° 140° 150° 160° 170° 180° 190° 200° 210° 220° 230° 240° 250° 260° 270° 280° 290° 300° 310° 320° 330° 340° 350° 
no overlaps over a full turn (every 10°)
26 pairs closer than 1 mm:
crankshaft3    × base-v1      gap  0.25 mm (closest at 250°)
crankshaft1    × cap          gap  0.25 mm (closest at 220°)
crankshaft2    × base-v1      gap  0.25 mm (closest at 110°)
crankshaft1    × base-v1      gap  0.25 mm (closest at 350°)
crankshaft3    × cap          gap  0.25 mm (closest at 310°)
crankshaft0    × base-v1      gap  0.25 mm (closest at 310°)
crankshaft2    × cap          gap  0.25 mm (closest at 10°)
crankshaft0    × cap          gap  0.25 mm (closest at 220°)
idler0         × base-v1      gap  0.45 mm (closest at 0°)
idler1         × base-v1      gap  0.45 mm (closest at 0°)
idler2         × base-v1      gap  0.45 mm (closest at 0°)
leg3L          × base-v1      gap  0.66 mm (closest at 0°)
leg3R          × base-v1      gap  0.76 mm (closest at 340°)
leg0R          × base-v1      gap  0.80 mm (closest at 170°)
leg3R          × cap          gap  0.81 mm (closest at 260°)
leg0L          × base-v1      gap  0.82 mm (closest at 0°)
leg3L          × cap          gap  0.84 mm (closest at 260°)
leg2L          × base-v1      gap  0.84 mm (closest at 150°)
leg1R          × base-v1      gap  0.84 mm (closest at 0°)
leg1L          × base-v1      gap  0.86 mm (closest at 330°)
leg0R          × cap          gap  0.87 mm (closest at 90°)
leg2R          × base-v1      gap  0.88 mm (closest at 140°)
leg0L          × cap          gap  0.94 mm (closest at 90°)
leg2L          × cap          gap  0.97 mm (closest at 90°)
leg2R          × cap          gap  0.97 mm (closest at 100°)
leg1R          × cap          gap  0.99 mm (closest at 270°)
