Morante-robotics/spider-bot-replica/cad/legs/check-result.txt

10° 20° 30° 40° 50° 60° 70° 80° 90° 100° 110° 120° 130° 140° 150° 160° 170° 180° 190° 200° 210° 220° 230° 240° 250° 260° 270° 280° 290° 300° 310° 320° 330° 340° 350° no overlaps over a full turn (every 10°)
23 pairs closer than 1 mm:
frame:test-frame   × keeper             gap  0.00 mm (closest at 0°)
frame:crankshaft1  × keeper             gap  0.25 mm (closest at 260°)
frame:crankshaft1  × test-frame         gap  0.25 mm (closest at 110°)
crankshaft3        × spine              gap  0.25 mm (closest at 160°)
crankshaft0        × spine              gap  0.25 mm (closest at 250°)
crankshaft1        × spine              gap  0.25 mm (closest at 310°)
crankshaft2        × spine              gap  0.25 mm (closest at 310°)
leg3R              × crankshaft3        gap  0.25 mm (closest at 300°)
leg0R              × crankshaft0        gap  0.25 mm (closest at 200°)
leg1R              × crankshaft1        gap  0.25 mm (closest at 270°)
leg2R              × crankshaft2        gap  0.25 mm (closest at 40°)
leg0L              × pivot0L            gap  0.50 mm (closest at 320°)
leg3R              × pivot3R            gap  0.50 mm (closest at 180°)
leg0R              × pivot0R            gap  0.50 mm (closest at 240°)
leg3L              × pivot3L            gap  0.50 mm (closest at 300°)
leg1R              × pivot1R            gap  0.50 mm (closest at 180°)
leg2R              × pivot2R            gap  0.50 mm (closest at 40°)
leg1L              × pivot1L            gap  0.50 mm (closest at 230°)
leg2L              × pivot2L            gap  0.50 mm (closest at 50°)
leg1L              × leg2L              gap  0.68 mm (closest at 170°)
leg1R              × leg2R              gap  0.68 mm (closest at 170°)
leg3L              × crankshaft3        gap  0.94 mm (closest at 350°)
leg0L              × crankshaft0        gap  0.96 mm (closest at 160°)
