Morante-robotics/spider-bot-replica/cad/gear-train-test/images/verify/section-1.png

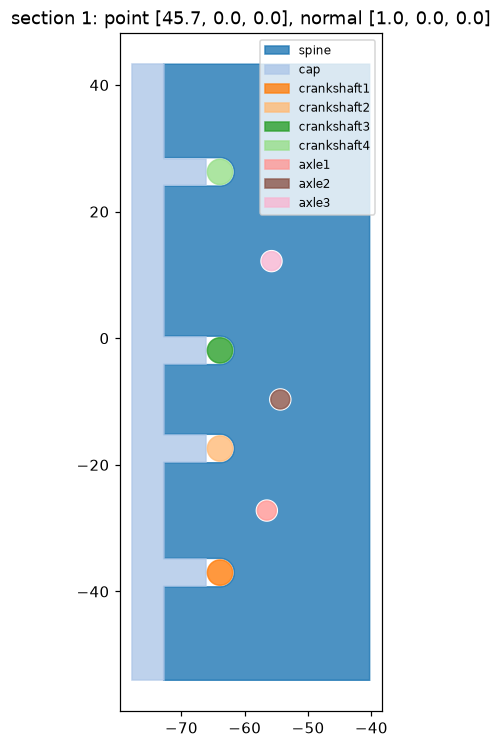
cad/gear-train-test/images/verify/section-1.png
