Morante-robotics/spider-bot-replica/cad/gear-train-test/images/verify/section-6.png

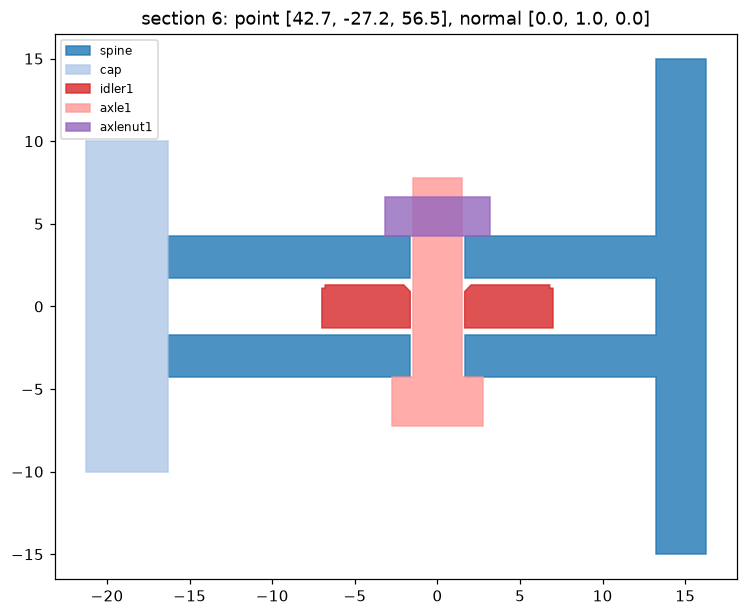
cad/gear-train-test/images/verify/section-6.png
