Morante-robotics/spider-bot-replica/cad/gear-train-test/images/verify/section-7.png

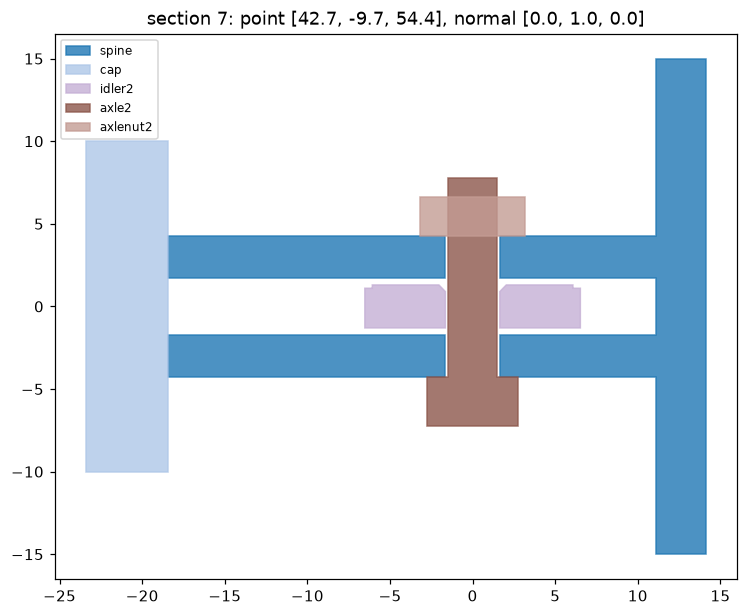
cad/gear-train-test/images/verify/section-7.png
