Morante-robotics/spider-bot-replica/cad/gear-train-test/images/verify/section-9.png

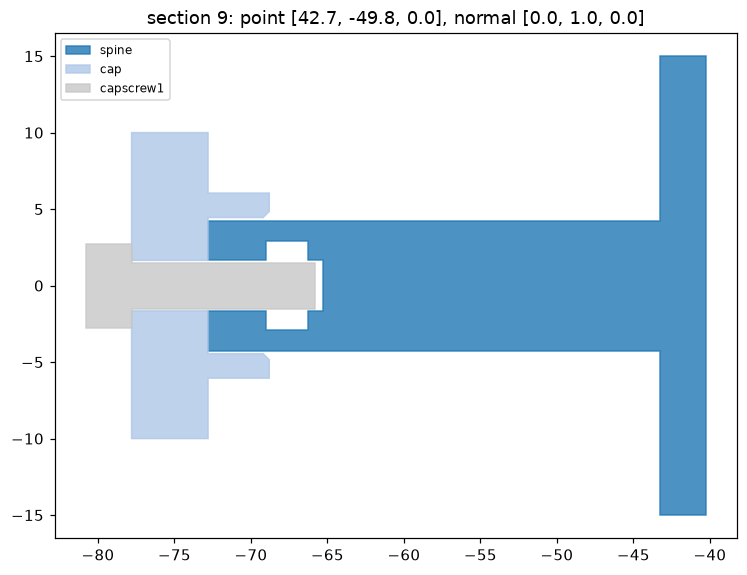
cad/gear-train-test/images/verify/section-9.png
