Morante-robotics/spider-bot-replica/(commit log)

2026-10-27 Add Spider-Bot capstone with Arduino Starter Kit R4 projects 2-5
2026-10-31 Move Arduino Starter Kit to its own top-level folder
    The Spider-Bot no longer has a microcontroller, so the kit projects
    are a separate foundations track rather than a Spider-Bot phase.
2026-11-07 Number capstones as a learning path
    Rename arduino-starter-kit/ to 0-arduino-starter-kit/ and spiderbot/ to
    1-spiderbot/. The root README is now one table of capstones with what each
    one teaches, including the planned quadruped and humanoid.
2026-11-07 Add Spider-Bot build log and carcass base model
    Carcass STLs by jenscolt (CC BY-NC-SA) with sizes, previews, turntable
    GIF and Bambu Studio import check; STL preview/turntable scripts; AI log.
    [spideybot_L_leg1.stl, spideybot_L_leg2.stl, spideybot_R_leg1.stl, spideybot_R_leg2.stl, spideybot_base.stl, spideybot_body.stl, spideybot_eye.stl, spideybot_sensor.stl]
2026-11-07 Show the whole Spider-Bot in carcass previews
    Assemble script places the eyes in their sockets and adds the other six
    legs (approximate layout); turntable GIF and Bambu Studio capture now show
    the full robot; faster Pillow turntable renderer.
2026-11-09 Choose Spider-Bot motor, battery holder and print scale
    N20 gear motor, 4xAAA holder with switch and cover, carcass at 120 %.
    Adds tools/fit_check.py to measure the free space inside the body.
2026-11-09 Repair Spider-Bot carcass meshes and scale to 120 %
    Body, base, eyes and sensor made watertight (Bambu Studio: manifold = yes),
    surface within 0.01 mm of the original. Adds tools/repair_stl.py.
    [spideybot_base.stl, spideybot_body.stl, spideybot_eye.stl, spideybot_sensor.stl, spideybot_small_eye.stl]
2026-11-09 Add Spider-Bot leg simulator and choose the Klann leg
    sim/legs.py compares a toy crank leg, Klann and Jansen over the half turn
    each leg carries the body. Klann chosen; real-size bar lengths in the build log.
2026-11-09 Choose the toy leg for the Spider-Bot
    Klann was dropped: the toy crank + sliding leg had been ruled out on a 2D
    model that cannot represent it. Build log now records the decision, how the
    leg works and the next steps (3D model, crank layout, CAD in build123d,
    assembly in Onshape).
2026-11-09 Model the Spider-Bot toy leg in 3D and choose one lateral crankshaft
    sim/toy_leg_3d.py simulates all 8 toy legs in the base rim notches over a
    crank turn: 3 crank axle directions x 2 joint types, each searched for its
    best geometry. Lateral axle sliding at the crank came closest to the targets.
    A shared-crankshaft mode with stricter clearance (every leg pair, inner arms,
    cranks inside the base and below the battery holder) showed the inner arms
    limit the stride to 14 mm per half turn; accepted for the simplest drive.
    [toy_leg_3d.py]
2026-11-09 Model the Spider-Bot legs and four-crankshaft drive in CAD
    One lateral crankshaft and two side crankshafts are ruled out in the
    simulator; four lateral crankshafts (one per leg pair, idler gears) are
    chosen. cad/drive/ models legs, pivot forks, one-piece crankshafts with
    involute gears, idlers, spine and a test frame in build123d, with a
    collision and gap check over a full crank turn.
    [crankshaft-1.stl, crankshaft-2.stl, crankshaft-3.stl, crankshaft-4.stl, idler-1.stl, idler-2.stl, idler-3.stl, leg-front-left.step]
2026-11-10 Add Onshape assembly tutorial for the Spider-Bot drive
2026-11-10 Spider-Bot: first print, purge waste bin
2026-11-10 Illustrate the Onshape tutorial and log the Spider-Bot leg assembly
2026-11-10 Spider-Bot build log: show the Onshape assembly animated
2026-11-10 Add clearance test and test leg print plate, lay the leg flat for printing
    [clearance-block.step, clearance-block.stl, clearance-pin.step, clearance-pin.stl, leg-front-left.step, leg-front-left.stl, leg-front-right.step, leg-front-right.stl]
2026-11-11 Fix the test frame from the first print and use the measured clearances
    The frame's arms ended at the centre of their holes and M3 would not go into
    the fork's tap holes: the fork now turns on two nut-locked M3 pins, and a
    keeper holds the crankshaft. Clearances from the clearance block: 0.5 mm for
    printed parts, 0.3 mm for steel. Screw diagram, photos and timelapse added.
    [idler-1.stl, idler-2.stl, idler-3.stl, leg-front-left.step, leg-front-left.stl, leg-front-right.step, leg-front-right.stl, leg-middle-left.step]
2026-11-11 Retouch the test leg photos lightly and record the v2 plate's slice
2026-11-11 Rewrite the Spider-Bot build log for readers
    Group entries by topic with a status column, add a glossary and a story
    paragraph per topic, open every entry with an «In short» summary, give
    every figure a fixed width and a numbered caption, and fold commands and
    full data tables into «How to reproduce» sections.
    The test-frame diagram now reads hole sizes from build.py (Ø3.3, was a
    stale Ø3.2 label).
2026-11-11 Build log: index first, open items and glossary last
    The contents become a numbered index with each topic's entries nested
    under it. Open items and the glossary move to the end; the glossary drops
    the test-frame diagram, which showed parts long before the entry that
    makes them, and links each term to the entry where it first appears. The
    test leg's six photos now sit together in one gallery.
2026-11-11 Goal photos, drive overview and READMEs without status
    Build log: jenscolt's photos of his printed Spidey-Bot open the log as the
    goal; the Legs and drive section opens with one figure of the three drives
    tried (new tools/drive_attempts_figure.py, from the simulator); every
    section ends with a link back to the contents.
    READMEs now describe what each folder holds and how to use it, and link
    to the build log for status, results and open items, so they only change
    when a folder's files change. Spider-Bot is «In progress» in the root
    README. check-result.txt no longer carries local paths from warnings.
2026-11-11 Test leg v2: the leg turns by hand; the fork needs a redesign
2026-11-11 Test leg v2: drop the full video, the fork was a print variation
2026-11-11 Spider-Bot base v1: band that lifts the body, built-in spine, fork mounts and cap
    - Fork window 0.5 mm a side; crankshaft 4's crank webs 1.5 mm, clear of the rear legs
    - The forks went into the carcass body: the body now sits 18.7 mm higher on a band
    - cad/base: hollow bowl, band, spine walls with keel, fork pockets and swivel screws,
    cap over the journal slots, separate front block; collision check over a full turn
    - Print plate print/base-v1.3mf (7 h 55 min, 139.9 g); build log, AI log and READMEs
    [cap.stl, crankshaft-4.stl, front-block.stl, leg-front-left.step, leg-front-right.step, leg-middle-left.step, leg-middle-right.step, leg-rear-left.step]
2026-11-11 Spider-Bot: gear train test plate, front block in the band figure, looks version noted
    - print/gear-train-test.3mf: loose spine, 4 crankshafts and 3 idlers (47 min, 16.5 g),
    to turn the gears by hand before printing base v1
    - Base figures draw every face in one collection, so the front block shows where it is
    - Open items: a base for looks once v1 works
    [gear-train-test.3mf]
2026-11-11 Spider-Bot: gear train test result and a shared CAD verifier
    The printed gear train jams and the crankshafts lift out of their open
    slots. tools/cad_verify.py (integrity, collisions with gears turning,
    backlash, retention, assembly order, overhangs) finds why: nothing holds
    the shafts down, idlers 1 and 2 cannot mesh both crankshafts at the
    designed crank phases, and there is no backlash.
2026-11-11 Spider-Bot: gear train v2 with gear offsets, backlash and a test cap
    Each crankshaft's gear is turned by its own offset so every idler meshes with
    both neighbours at the gait angles; idlers 12/12/20 teeth; ~0.2 mm backlash;
    test cap and assembly dots; base v1 keel rebuilt. cad_verify PASS. Build log,
    AI log and READMEs updated; the verifier now prints the time of each check.
    [assembly-0.stl, base-v1.stl, crankshaft-1.step, crankshaft-1.stl, crankshaft-2.step, crankshaft-2.stl, crankshaft-3.step, crankshaft-3.stl]
2026-11-12 Spider-Bot: gear train test v2 turns with a new test cap
    The first test cap jammed the train: its tongues ran 0.25 mm from the gear
    faces and only its screws located it sideways. The new cap has narrow tongues
    over the outer part of each wall (0.9 mm worst-case clearance) and four skirts
    that centre it. cad_verify gains keep-out zones and the spec poses the cap at
    its extremes. Base v1's cap gets the same fix; plates re-sliced. Build log,
    AI log, READMEs and the assembly diagram added.
    [base-v1.3mf, cap.stl, gear-train-test-v2.3mf, test-cap-v2.3mf, test-cap.step, test-cap.stl]
2026-11-12 Spider-Bot: legs and forks plate for base v1
    All 8 legs and 8 forks on one plate (2 h 30 min, 46.9 g). Bambu Studio's
    arrange fit only three L-shaped legs per plate, so bambu_plate.py gains
    :x,y fixed placement (no arrange) and the legs are nested by hand.
    [legs-forks-v1.3mf]
2026-11-13 Measured fits, faster CAD checks, house-style figures and a workshop kit
    - 1-spiderbot/cad/fits.py: the measured clearances, the one place every design takes them from
    - cad_verify: JOINTS (fits against fits.py), MARKS, support standing on the part itself; repeated pair positions
    reused, retention pushed only to the allowed play, assembly tested only where boxes meet, shorter gap search,
    motion check on every core, --only for partial runs. Gear train test: full check 201 s -> 101 s
    - figures.py: assembly steps, exploded view and measuring sheet with correct depth order and outlines
    - workshop_kit.py: one-page assembly sheet for the bench, built from a design's spec
    - print_report.py: sup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
2026-11-13 Reproducible environment, shared tools with tests, design template, split build log
    - pyproject.toml + uv.lock: uv sync recreates the environment (office and mesh-repair groups optional)
    - tools/: bambu_plate (with --standard settings), stl_preview, stl_turntable, repair_stl moved from 1-spiderbot;
    tests for cad_verify (every failure that reached a print) run on GitHub; rel_key normalises -0.0
    - 1-spiderbot/cad/README.md: axes, design-folder layout, what is kept in git; cad/_template/ to start a design
    - 1-spiderbot/hardware.md and measurements.csv; print/README.md standard settings
    - build log split by topic into build-log/<n>-<topic>.md; every link in the repo updated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
    [measurements.csv]
2026-11-13 cad_verify: seats, thin upright pegs, gears over one tooth, results cached between runs
    - SEATS: a part that must sit fully home fails when it floats above its seat (base v1's big gear)
    - print check warns about pegs and posts printed upright thinner than Ø4 (base v1's pegs)
    - GEAR_MOTION: meshing pairs checked over their own steps (one tooth pitch) instead of the whole MOTION
    - .cad_verify_cache.pkl keeps pair results between runs (gitignored; --no-cache), saved even if a check crashes
    - tests for each; the tests workflow can be run by hand
2026-11-13 Open items: base v1's print result, the CAD tasks before base v2, calibration and hardware count
2026-11-14 CAD: drive and base move to the design-folder layout
    cad/drive/ splits into one design per function (legs, crankshafts,
    gear-train-test, test-frame) and cad/base/ writes its parts to out/.
    Shared code is in cad/common.py and designs import each other with
    cad.design(name) instead of file-path loading. Every STL rebuilds
    byte-identical and every check gives the same verdict as before.
    [assembly-0.stl, base-v1.stl, cap.stl, crankshaft-1.step, crankshaft-1.stl, crankshaft-2.step, crankshaft-2.stl, crankshaft-3.step]
2026-11-14 Base v1: print and first fitting
    Base v1 printed but could not be assembled: the cap's tongues broke
    when pressed in, the front block's pegs and posts broke, the idler
    pins were unreachable, the big gear stood proud and support stayed
    trapped. Entry with the timelapse, photos and a cap failure figure;
    Open items now point to base v2. Build-log links follow the new CAD
    folders.
2026-11-14 Whole robot first: motor sizing and the approved chassis plan
    Base v1 had no place for the motor or the batteries, so the whole robot, in its looks version, is now modelled
    and checked in CAD before anything else is printed; coupons follow as one batch, then the v0 chassis. The motor
    is sized (Pololu HP 6 V 380:1) and the chassis plan (rev 4) is approved; modelling parts A, B and C are next.
